bobcat-ft/hardware/microphone_array_adapter_board/readme.md

Adapter board used to interface with a 4x4 [TDK Invensense ICS-52000 eval board](https://www.digikey.com/en/product-highlight/i/invensense/ics-52000-tdm-array-demo-board).

The eval board is a 4x4 array of ICS-52000 bottom-port MEMs microphones.
