bobcat-ft/hardware/audio_beamforming_daughter_board/audio_beamforming_daughter_board.png

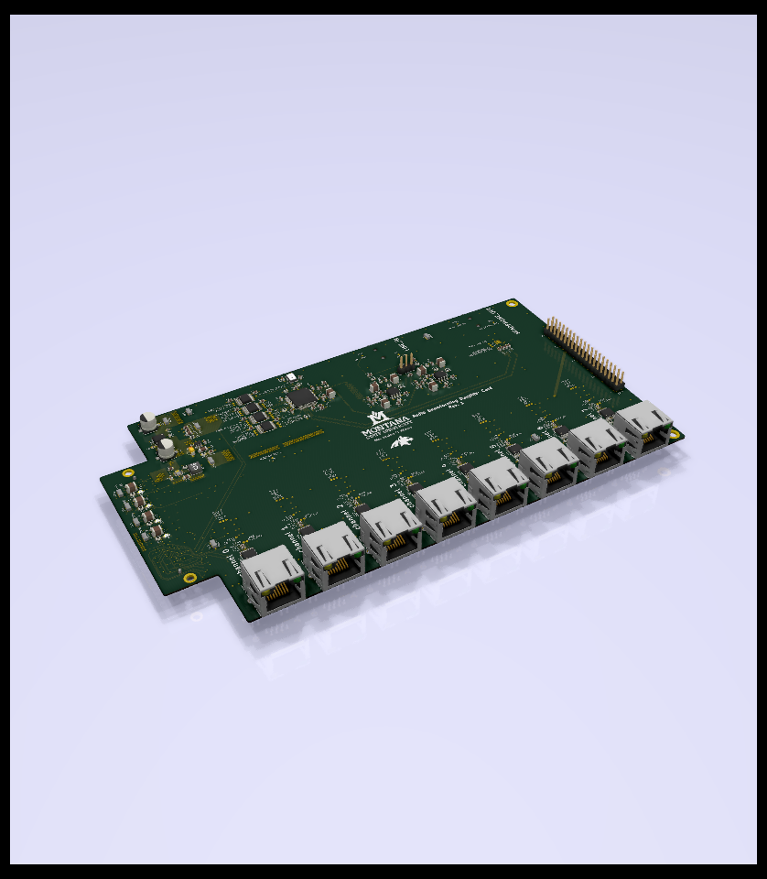
audio_beamforming_daughter_board/audio_beamforming_daughter_board.png
