bobcat-ft/hardware/microphone_array_adapter_board/microphone_array_adapter_board.png

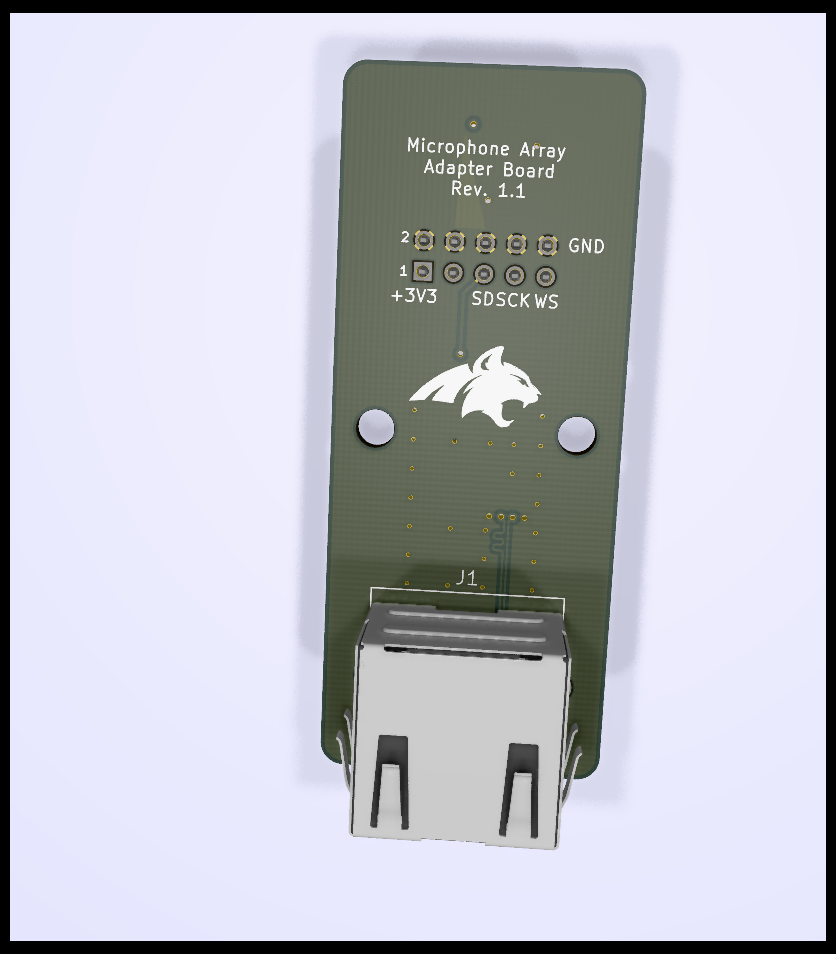
microphone_array_adapter_board/microphone_array_adapter_board.png
