bobcat-ft/hardware/microphone_array_adapter_board/microphone_array_adapter_board.stl

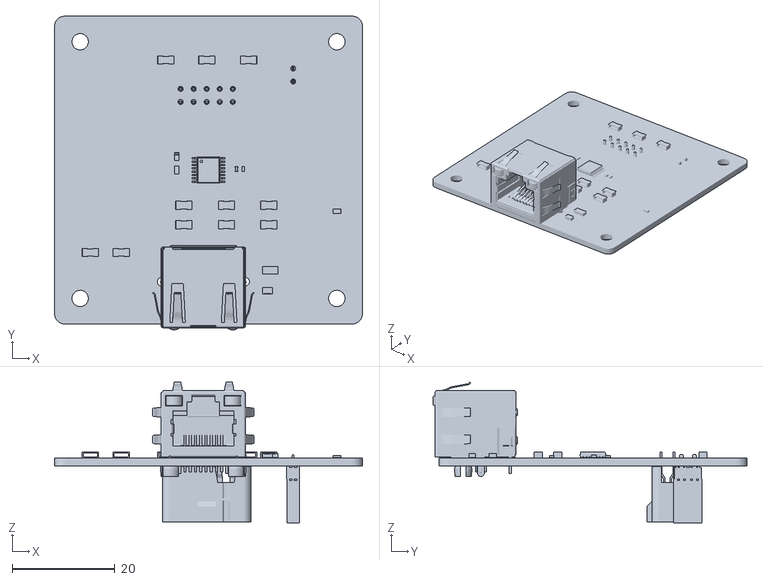
[picture p3: CAD file, 2020-04-23]
microphone_array_adapter_board/microphone_array_adapter_board.stl
60.0 x 61.1 x 27.4
