bobcat-ft/hardware/audio_beamforming_daughter_board/audio_beamforming_daughter_board.pdf

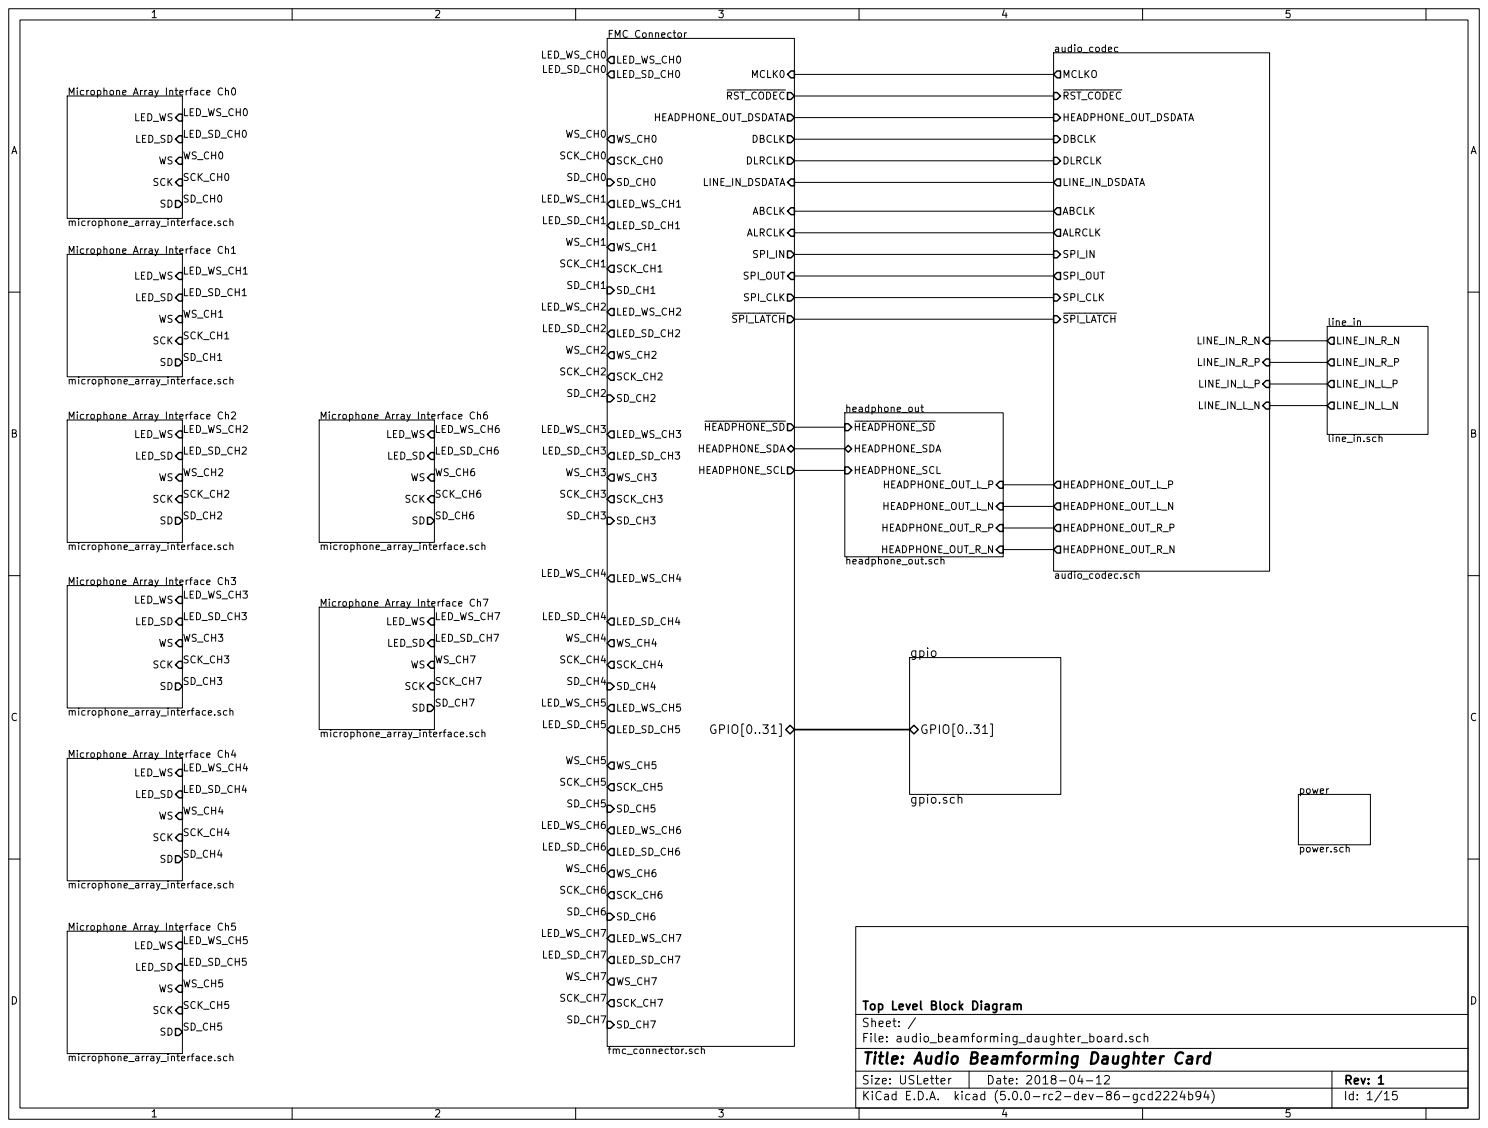
[picture p4: page 1]

File: audio_beamforming_daughter_board.sch Sheet: / Top Level Block Diagram

Id: 1/15 Title: Audio Beamforming Daughter Card

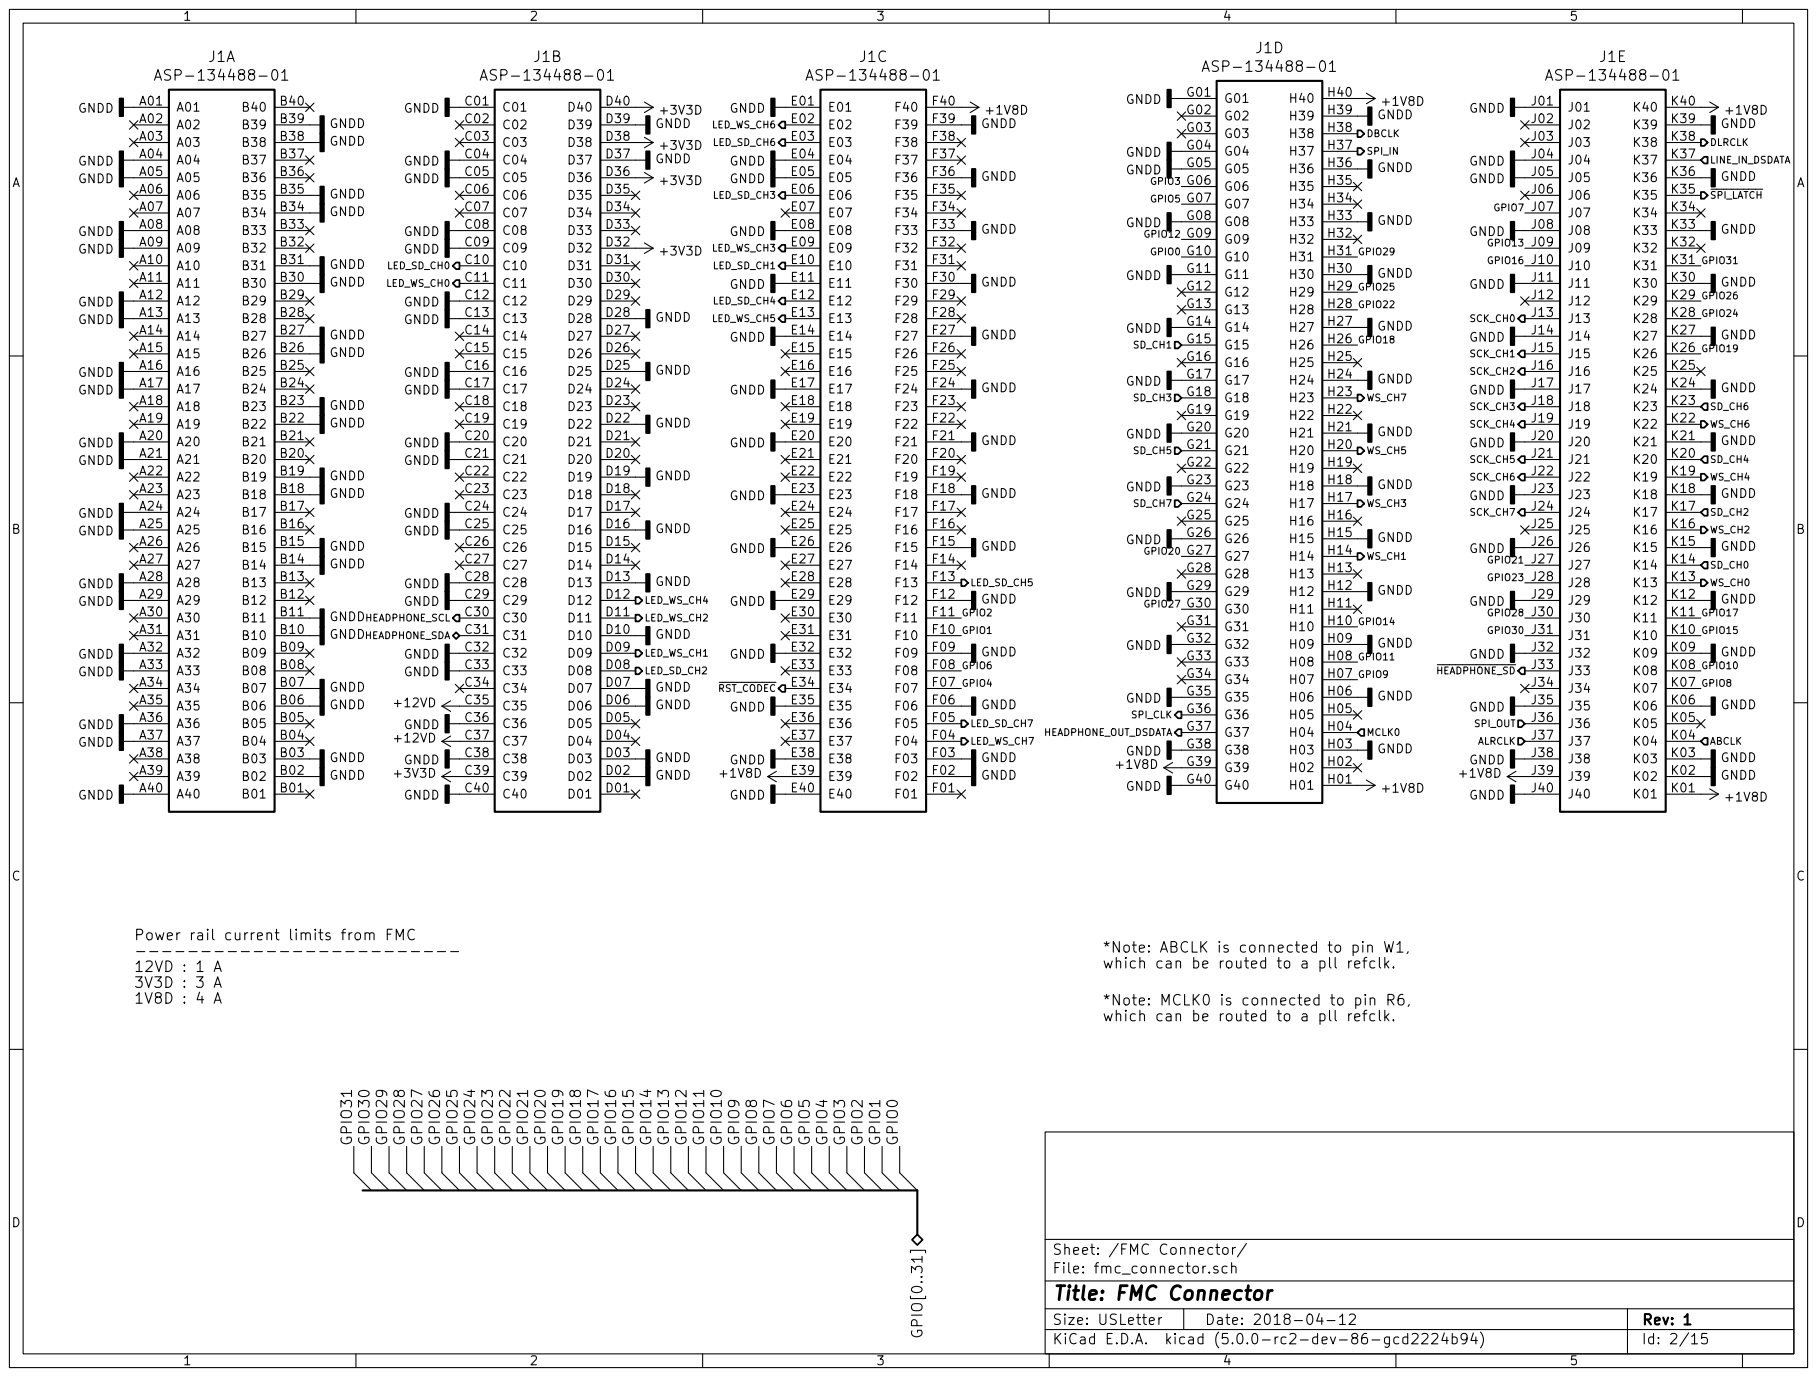
[picture p5: page 2]

*Note: ABCLK is connected to pin W1,
which can be routed to a pll refclk.

*Note: MCLK0 is connected to pin R6,

File: fmc_connector.sch Sheet: /FMC Connector/
Id: 2/15 Title: FMC Connector

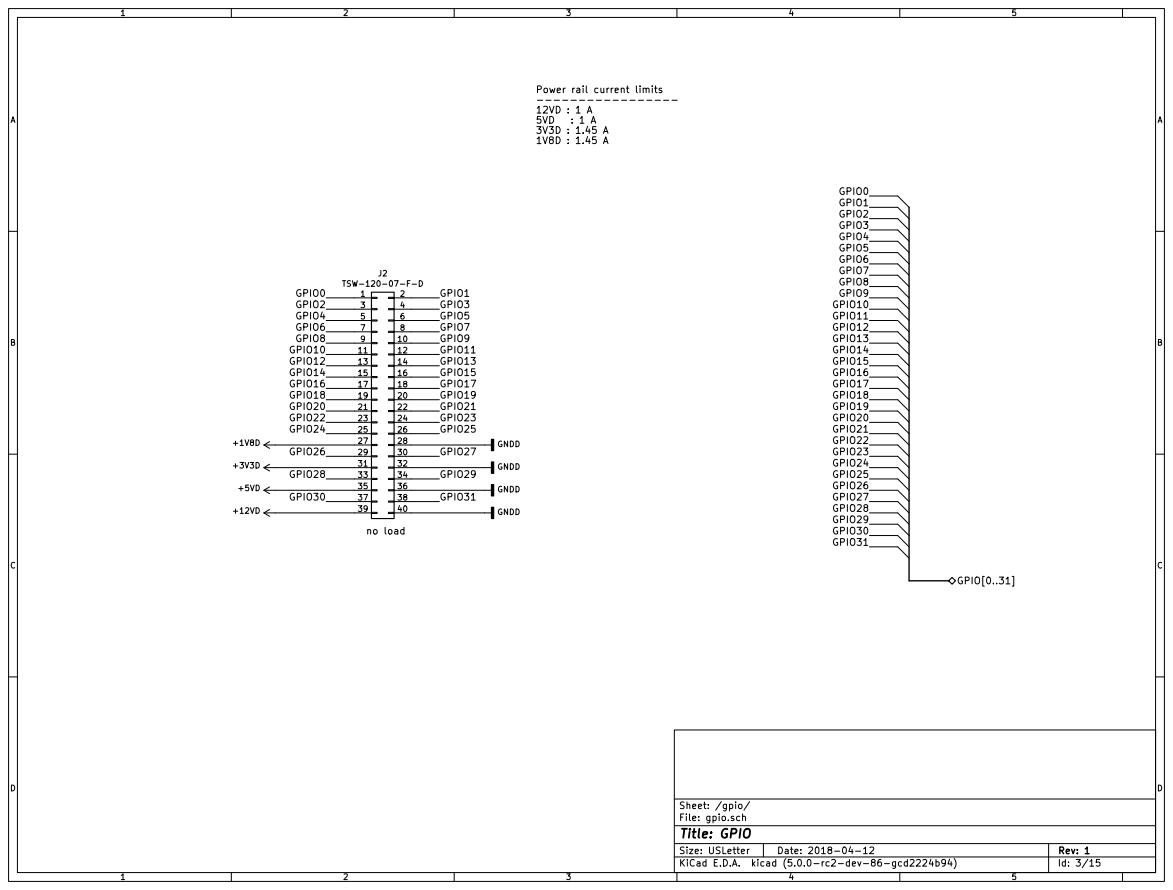
[picture p6: page 3]

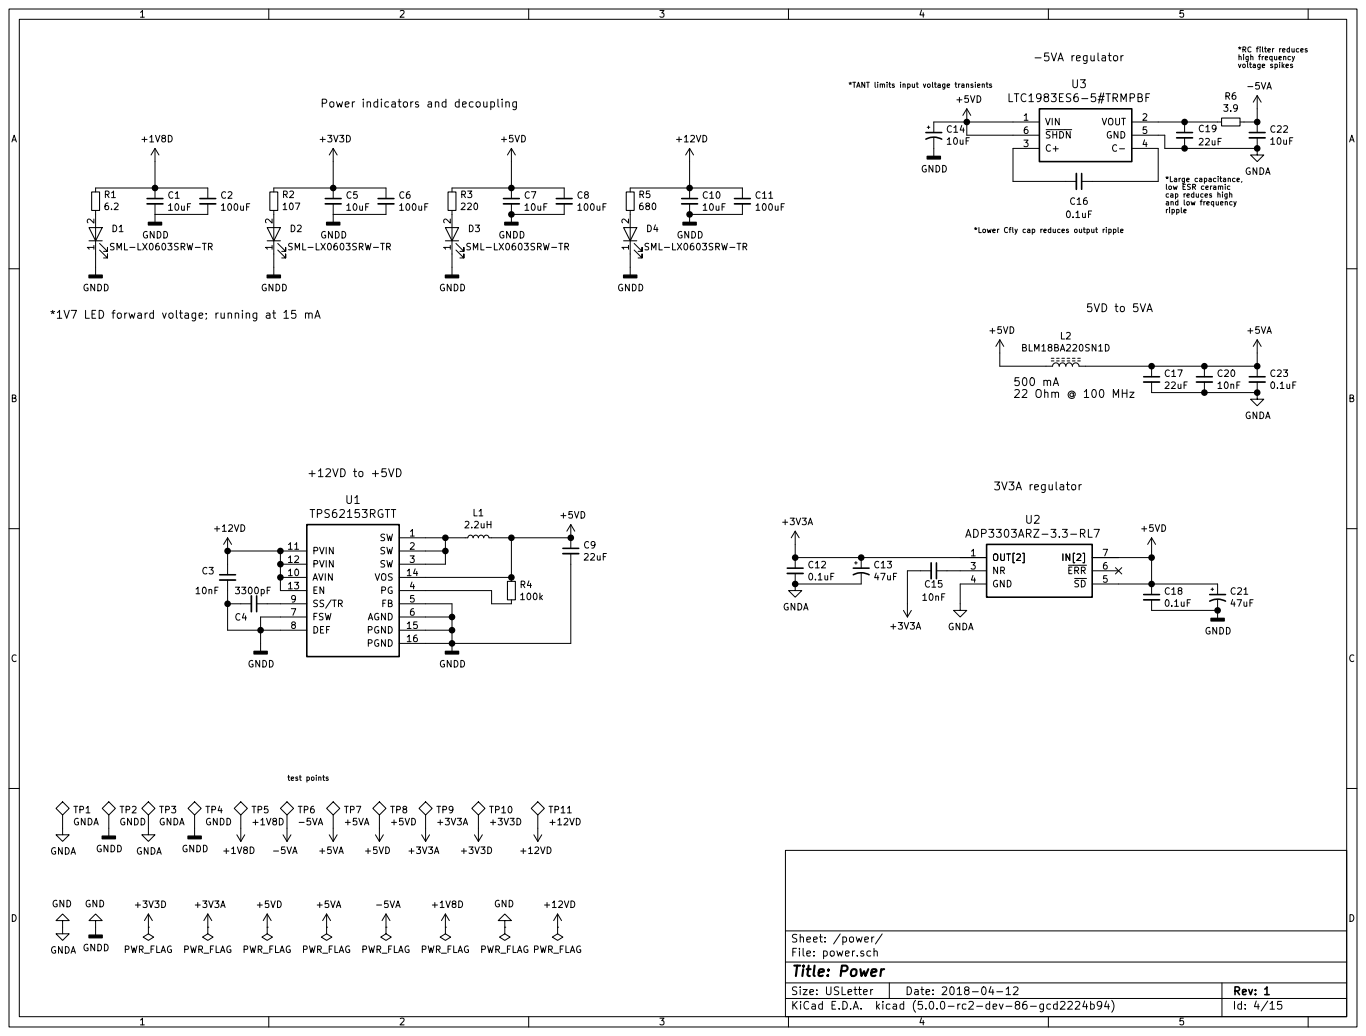
[picture p7: page 4]

*RC filter reduces high frequency voltage spikes

-5VA Power indicators and decoupling

*TANT limits input voltage transients

*Large capacitance,
low ESR ceramic cap reduces high
and low frequency
ripple

*Lower Cfly cap reduces output ripple

*1V7 LED forward voltage; running at 15 mA

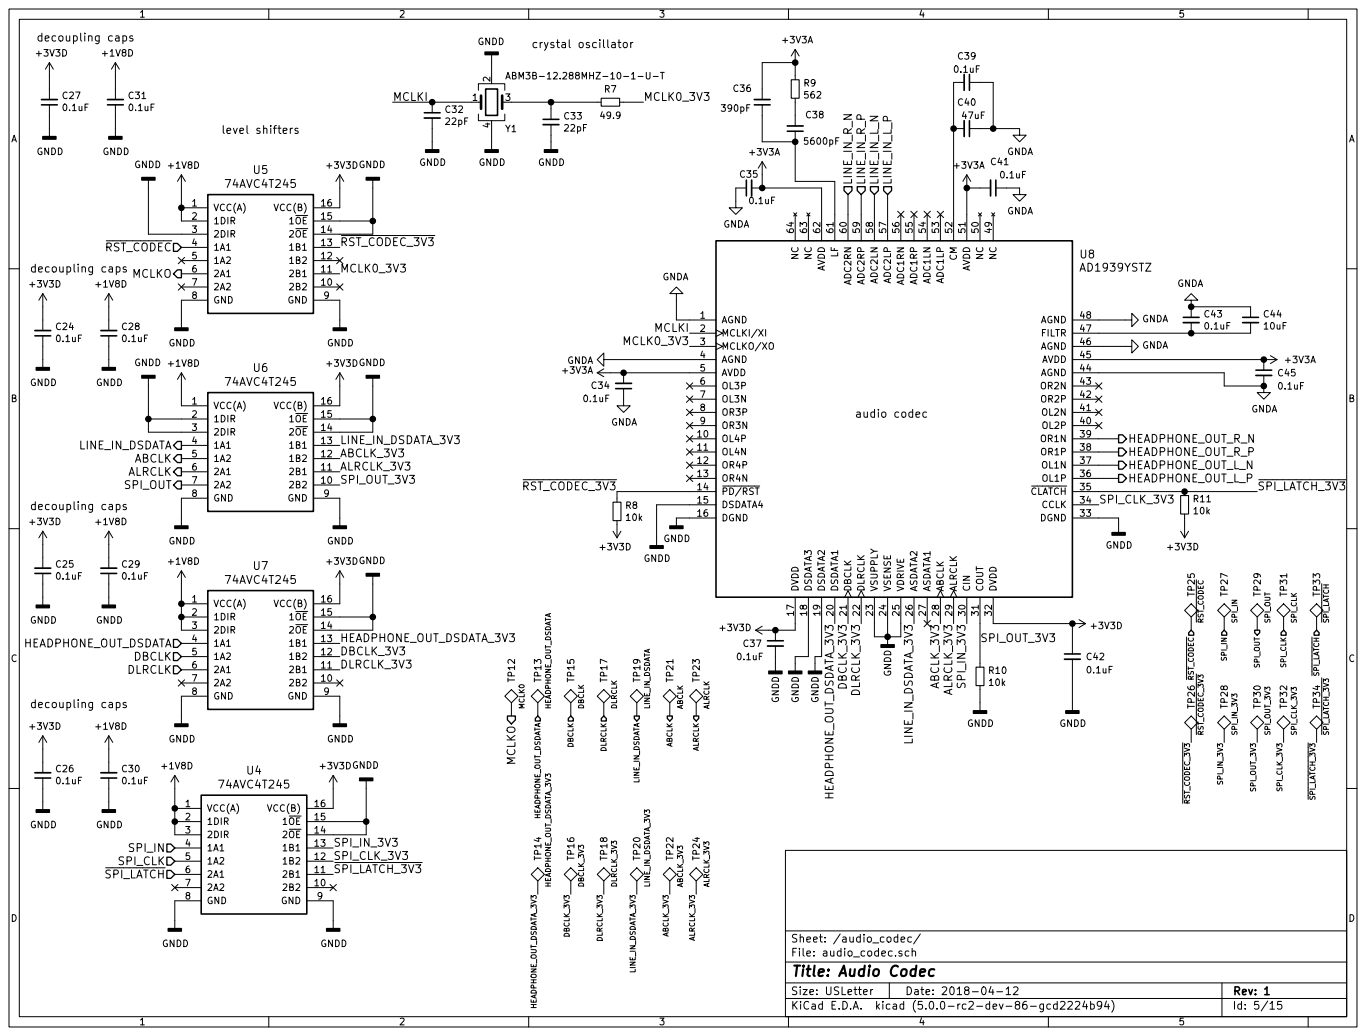
[picture p8: page 5]

4Y1 ABM3B-12.288MHZ-10-1-U-T AGND 1 MCLKI/XI 2 MCLKO/XO 3 AGND 4 AVDD 5 OL3P 6 OL3N 7 OR3P 8 OR3N 9 OL4P 10 OL4N 11 OR4P 12 OR4N 13 PD/RST 14 DSDATA4 15 DGND 16 DVDD 17 DSDATA3 18 DSDATA2 19 DSDATA1 20 DBCLK 21 DLRCLK 22 VSUPPLY 23 VSENSE 24 VDRIVE 25 ASDATA2 26 ASDATA1 27 ABCLK 28 ALRCLK 29 CIN 30 COUT 31 DVDD 32 DGND 33 CCLK 34 CLATCH 35 OL1P 36 OL1N 37 OR1P 38 OR1N 39 OL2P 40 OL2N 41 OR2P 42 OR2N 43 AGND 44 AVDD 45 AGND 46 FILTR 47 AGND 48 NC 49 NC 50 AVDD 51 CM 52 ADC1LP 53 ADC1LN 54 ADC1RP 55 ADC1RN 56 ADC2LP 57 ADC2LN 58 ADC2RP 59 ADC2RN 60 LF 61 AVDD 62 NC 63 NC 64 U8AD1939YSTZ GNDD GNDD

Sheet: /audio_codec/
File: audio_codec.sch
Id: 5/15 Title: Audio Codec

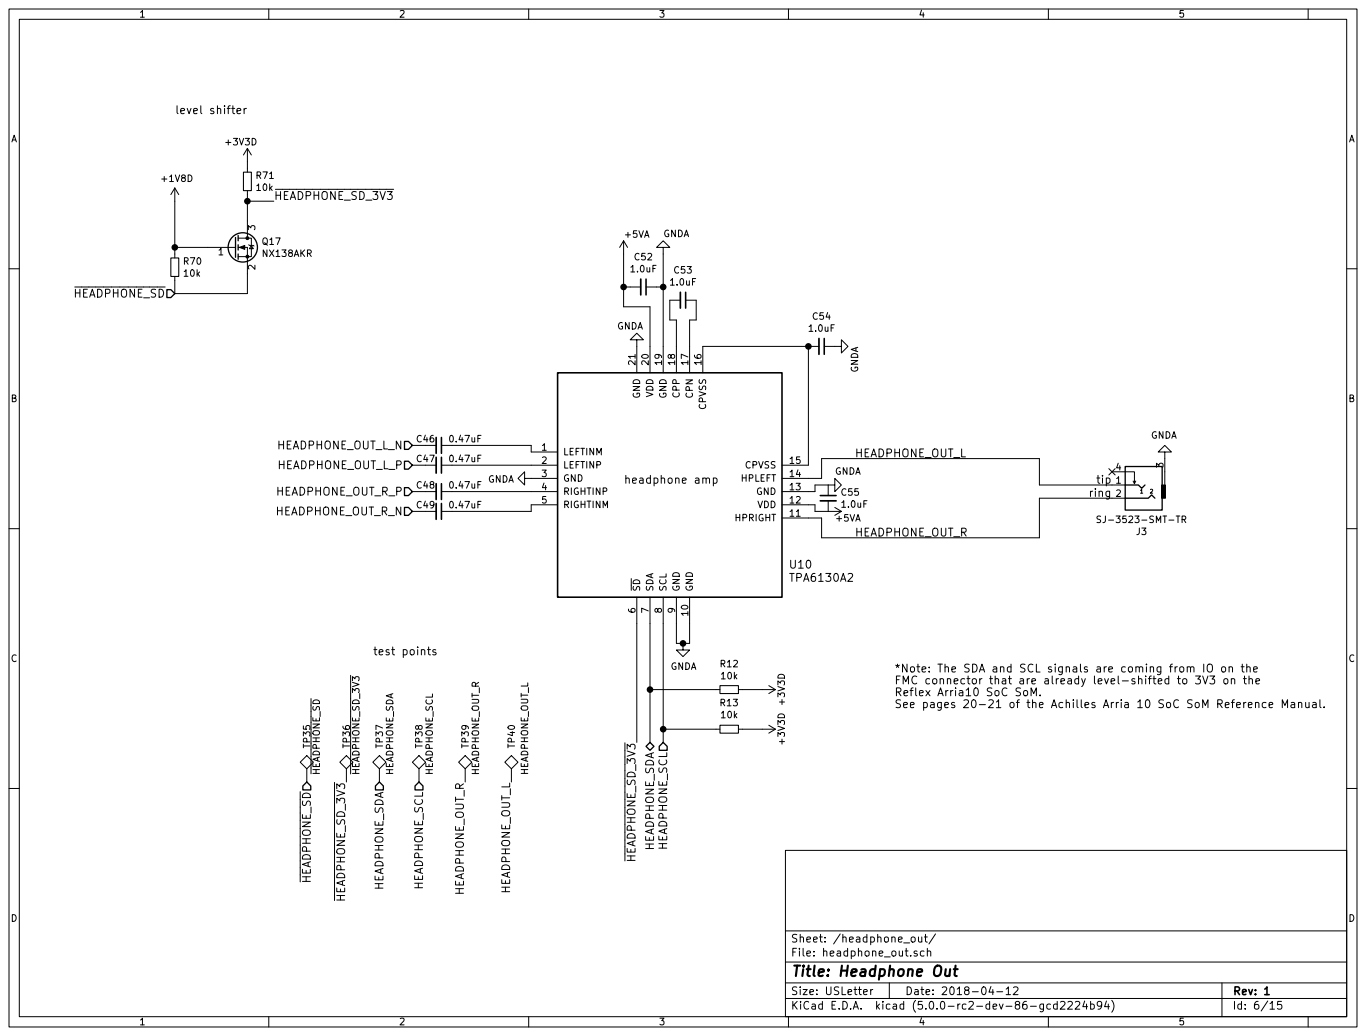
[picture p9: page 6]

9 GND 10 HPRIGHT 11 VDD 12 GND 13 HPLEFT 14 CPVSS 15 CPVSS 16 CPN 17 CPP 18 GND 19 VDD 20 GND 21 U10 TPA6130A2

J3 SJ-3523-SMT-TR GNDA

*Note: The SDA and SCL signals are coming from IO on the
FMC connector that are already level-shifted to 3V3 on the
Reflex Arria10 SoC SoM.
See pages 20-21 of the Achilles Arria 10 SoC SoM Reference Manual.

Sheet: /headphone_out/
File: headphone_out.sch
Id: 6/15 Title: Headphone Out

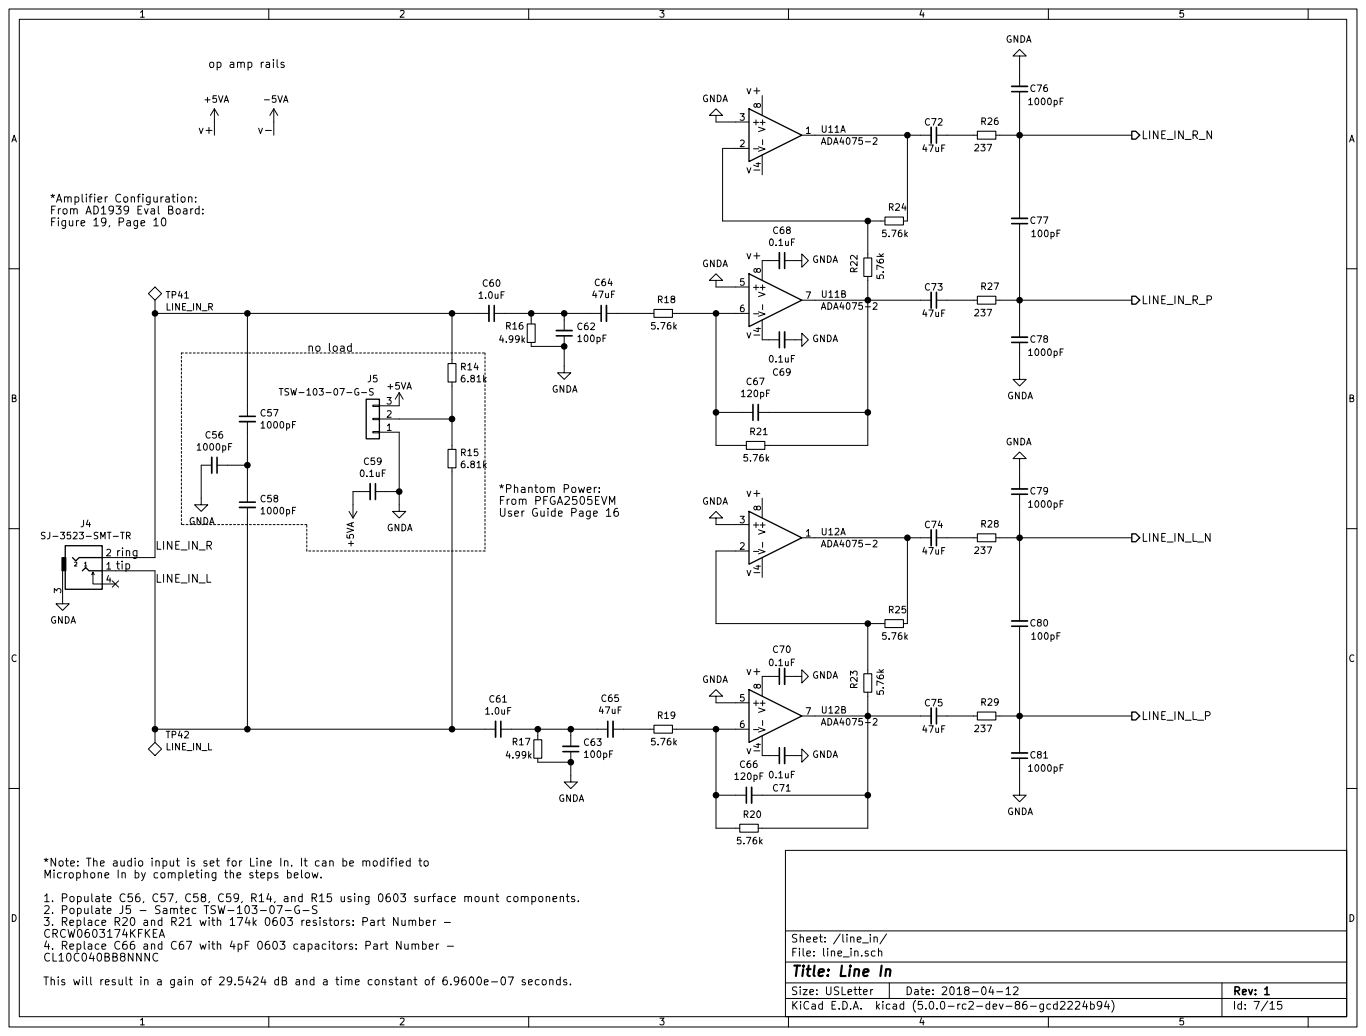
[picture p10: page 7]

*Amplifier Configuration: From AD1939 Eval Board: Figure 19, Page 10

*Note: The audio input is set for Line In. It can be modified to
Microphone In by completing the steps below.
1. Populate C56, C57, C58, C59, R14, and R15 using 0603 surface mount components.
2. Populate J5 - Samtec TSW-103-07-G-S
3. Replace R20 and R21 with 174k 0603 resistors: Part Number -
CRCW0603174KFKEA
4. Replace C66 and C67 with 4pF 0603 capacitors: Part Number -
CL10C040BB8NNNC
This will result in a gain of 29.5424 dB and a time constant of 6.9600e-07 seconds.

Sheet: /line_in/
File: line_in.sch
Id: 7/15 Title: Line In

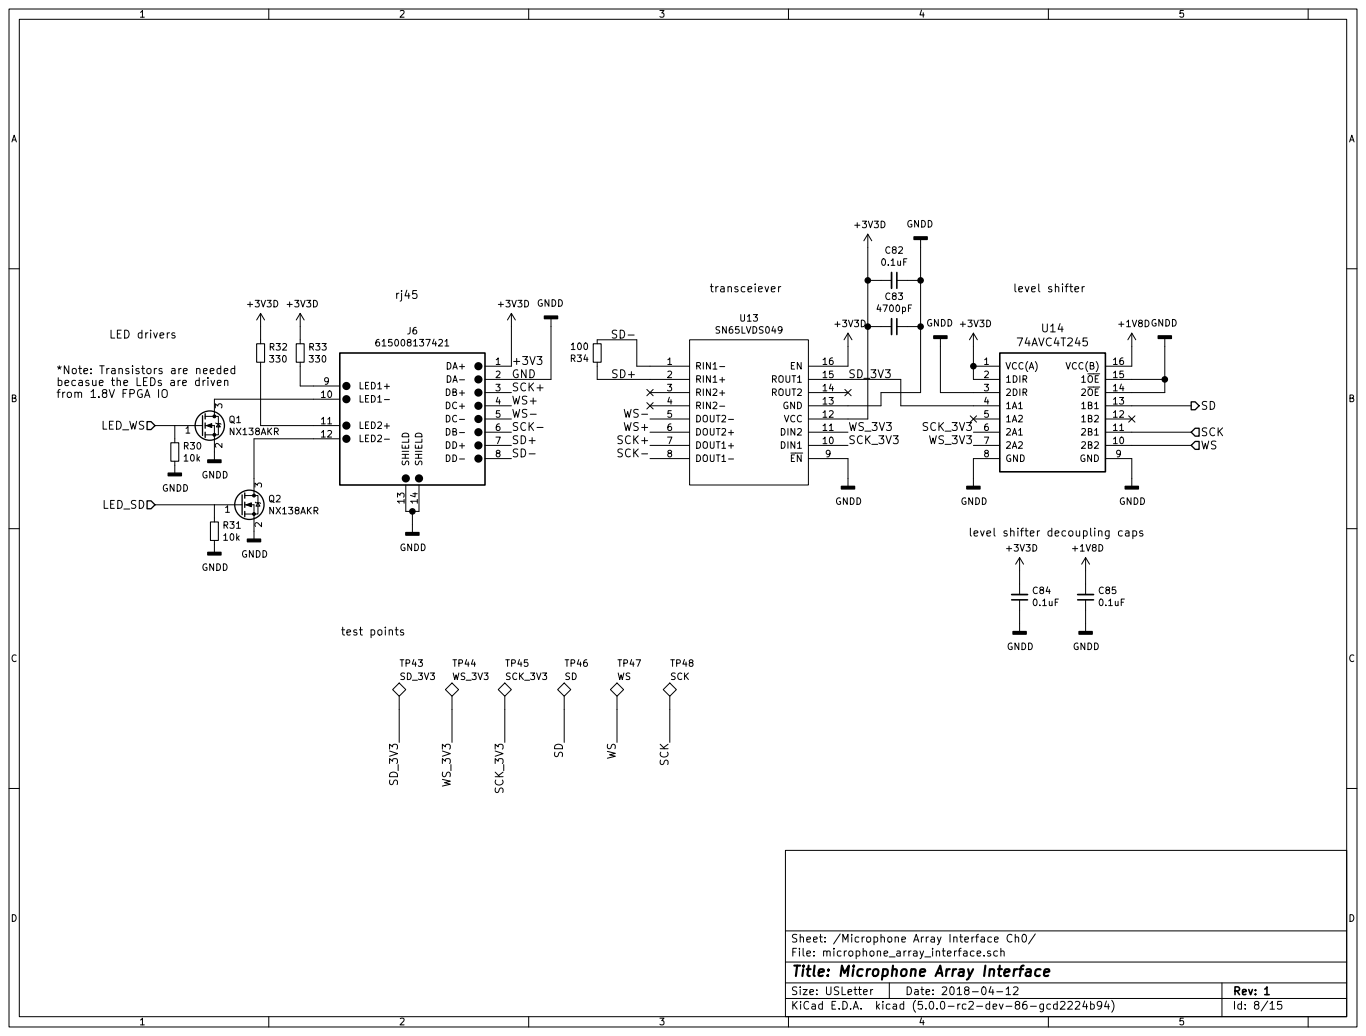
[picture p11: page 8]

*Note: Transistors are needed becasue the LEDs are driven
from 1.8V FPGA IO

level shifter decoupling caps

Sheet: /Microphone Array Interface Ch0/
File: microphone_array_interface.sch
Id: 8/15 Title: Microphone Array Interface

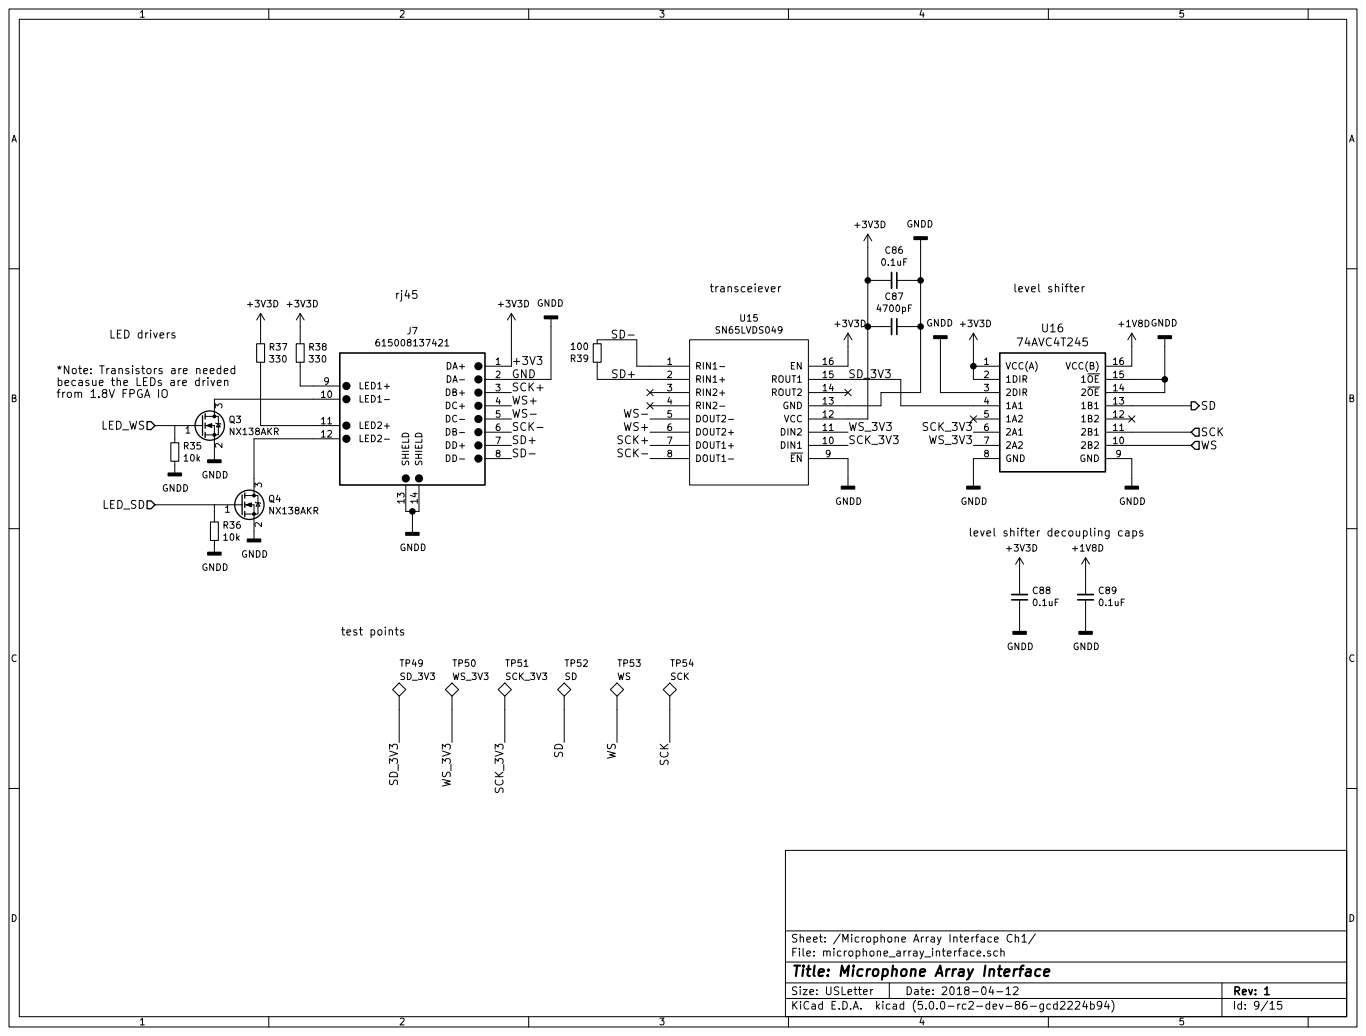
[picture p12: page 9]

*Note: Transistors are needed becasue the LEDs are driven
from 1.8V FPGA IO

level shifter decoupling caps

Sheet: /Microphone Array Interface Ch1/
File: microphone_array_interface.sch
Id: 9/15 Title: Microphone Array Interface

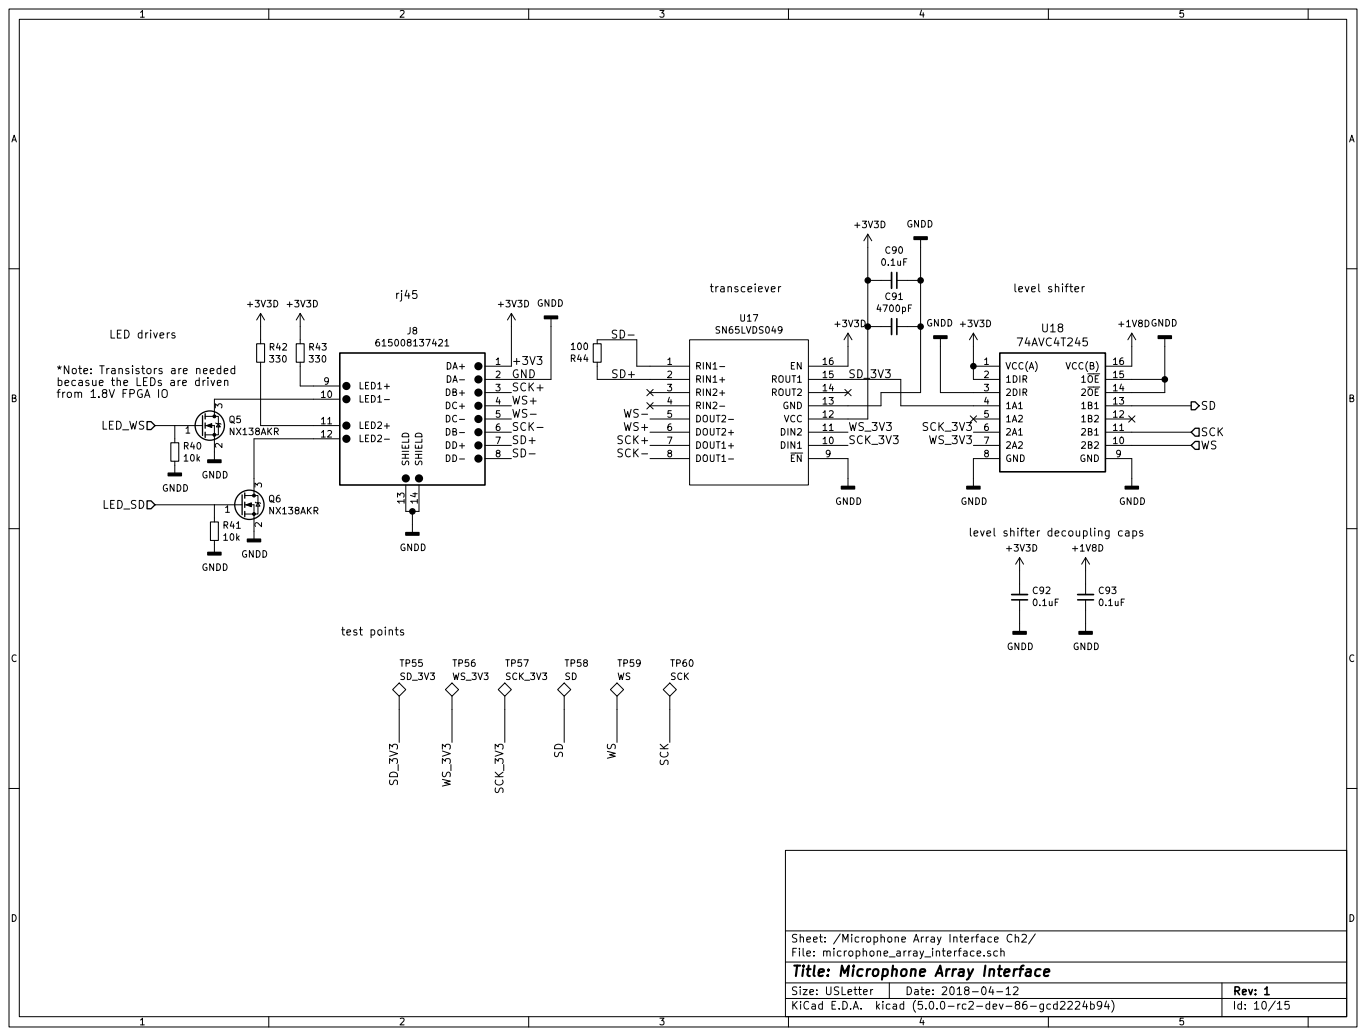
[picture p13: page 10]

*Note: Transistors are needed becasue the LEDs are driven
from 1.8V FPGA IO

level shifter decoupling caps

Sheet: /Microphone Array Interface Ch2/
File: microphone_array_interface.sch
Id: 10/15 Title: Microphone Array Interface

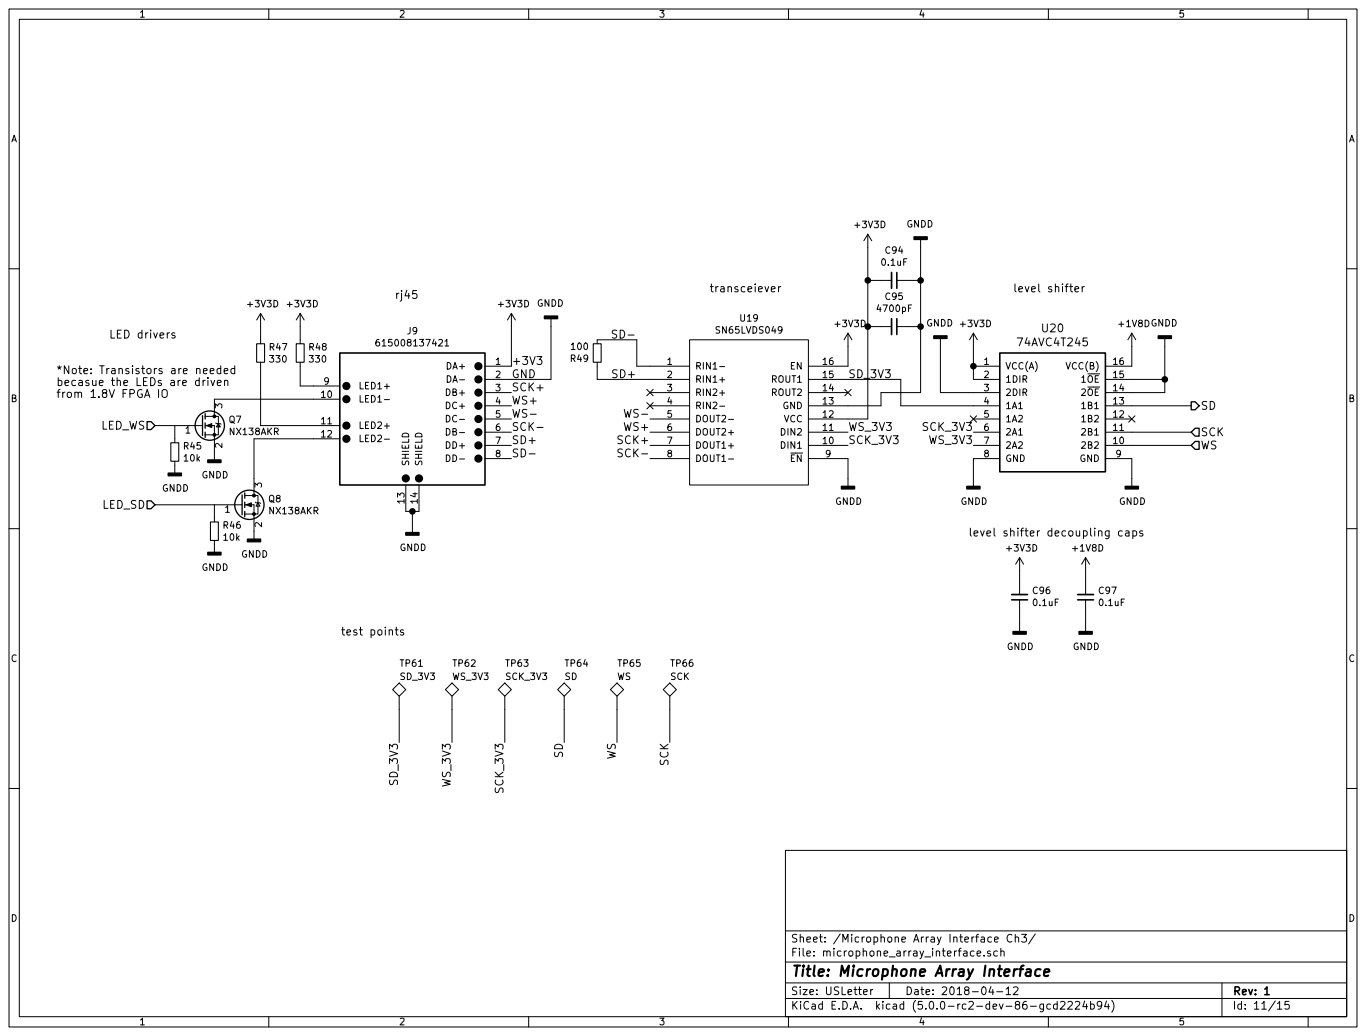
[picture p14: page 11]

*Note: Transistors are needed becasue the LEDs are driven
from 1.8V FPGA IO

level shifter decoupling caps

Sheet: /Microphone Array Interface Ch3/
File: microphone_array_interface.sch
Id: 11/15 Title: Microphone Array Interface

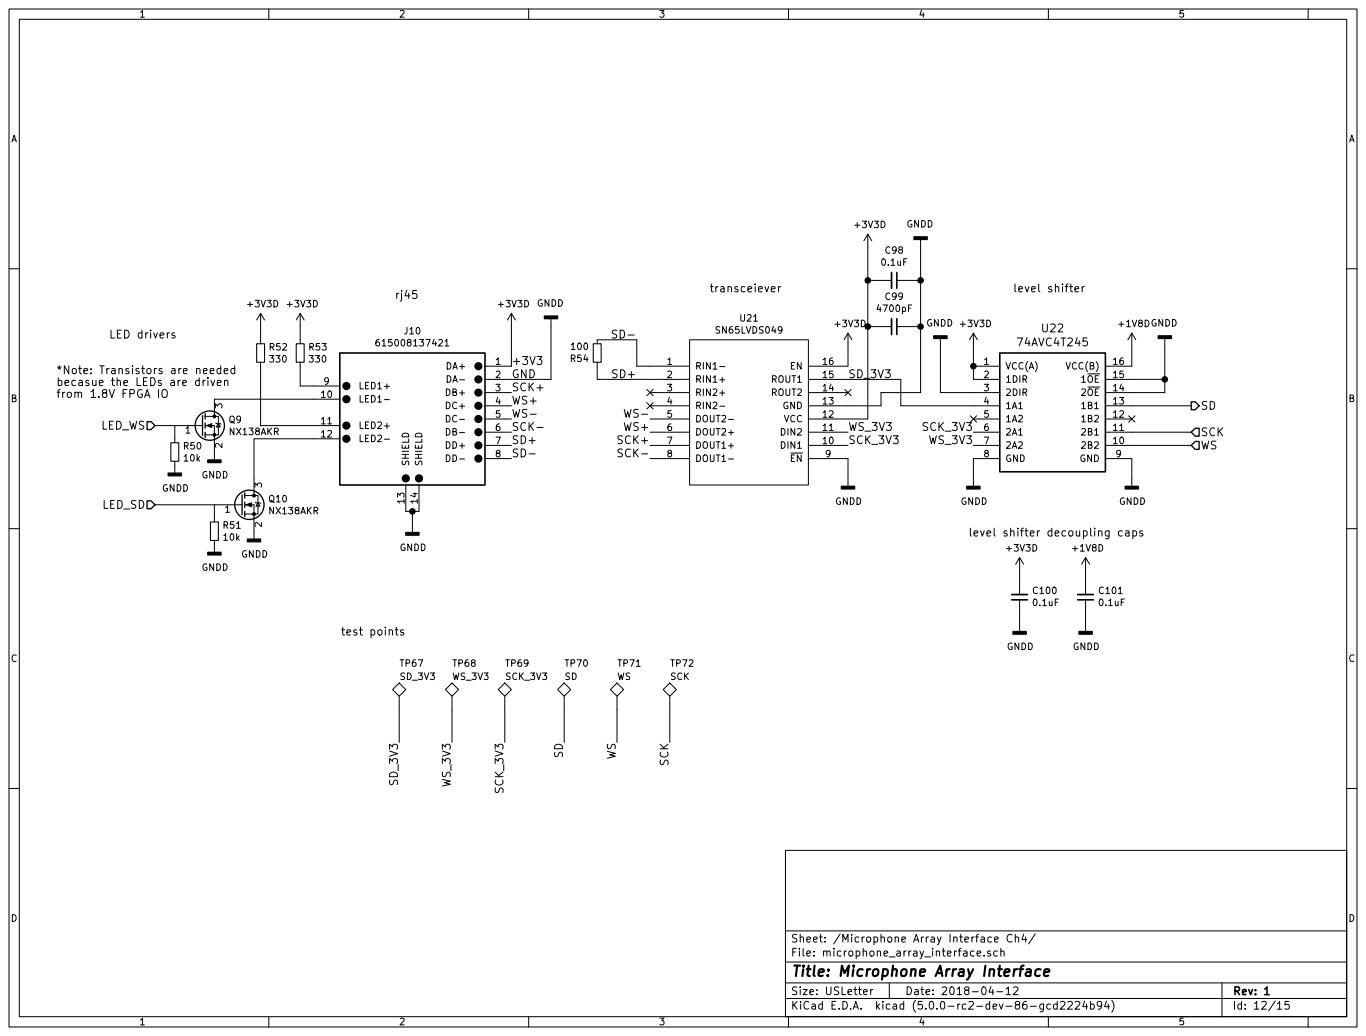
[picture p15: page 12]

*Note: Transistors are needed becasue the LEDs are driven
from 1.8V FPGA IO

level shifter decoupling caps

Sheet: /Microphone Array Interface Ch4/
File: microphone_array_interface.sch
Id: 12/15 Title: Microphone Array Interface

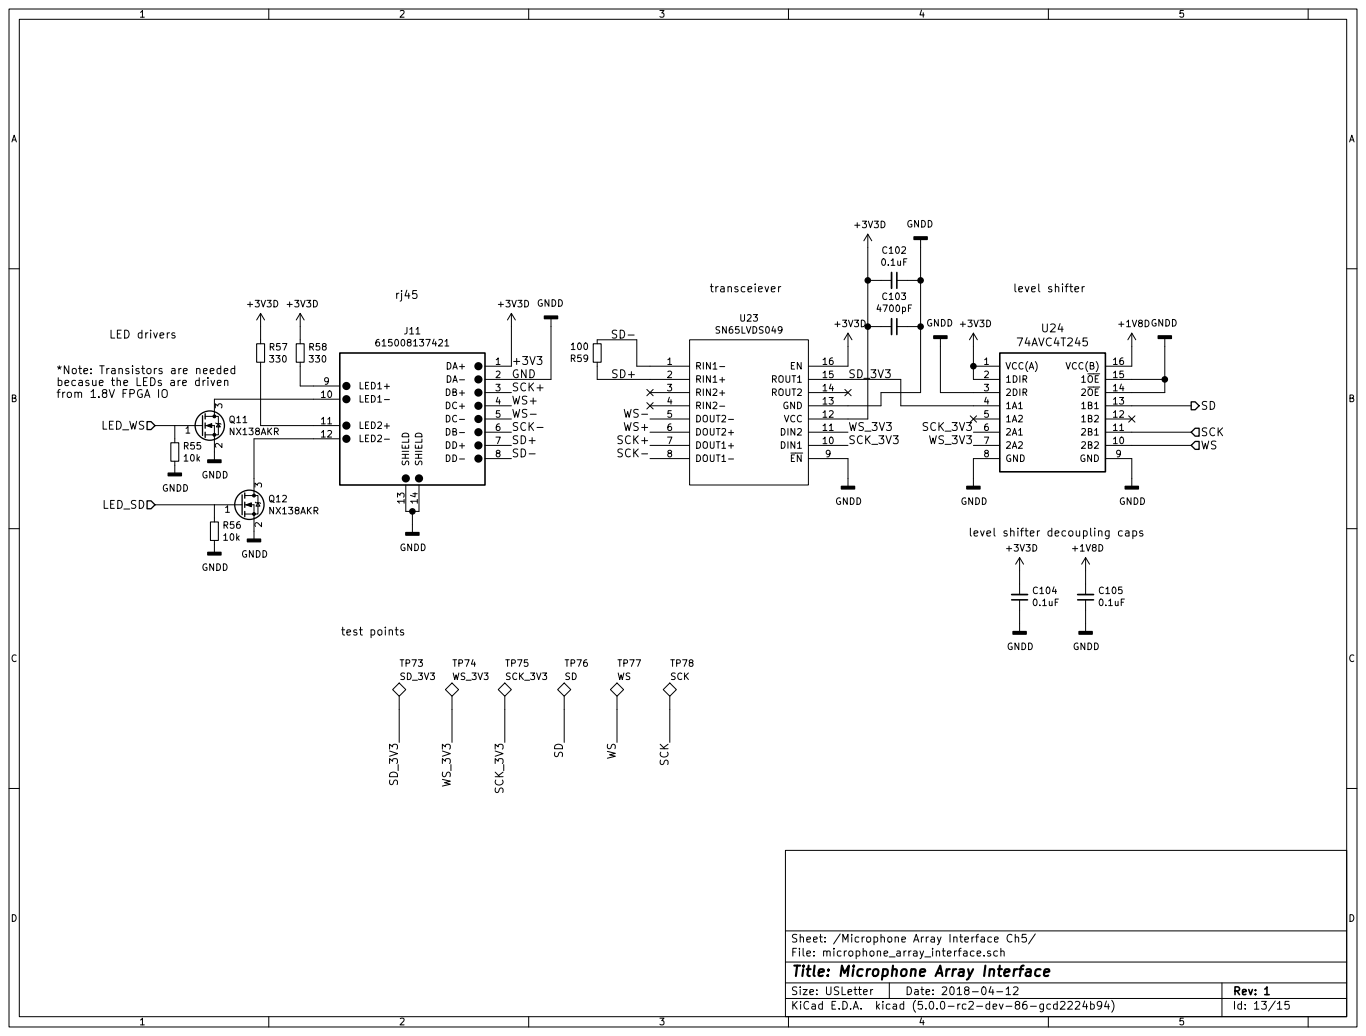
[picture p16: page 13]

*Note: Transistors are needed becasue the LEDs are driven
from 1.8V FPGA IO

level shifter decoupling caps

Sheet: /Microphone Array Interface Ch5/
File: microphone_array_interface.sch
Id: 13/15 Title: Microphone Array Interface

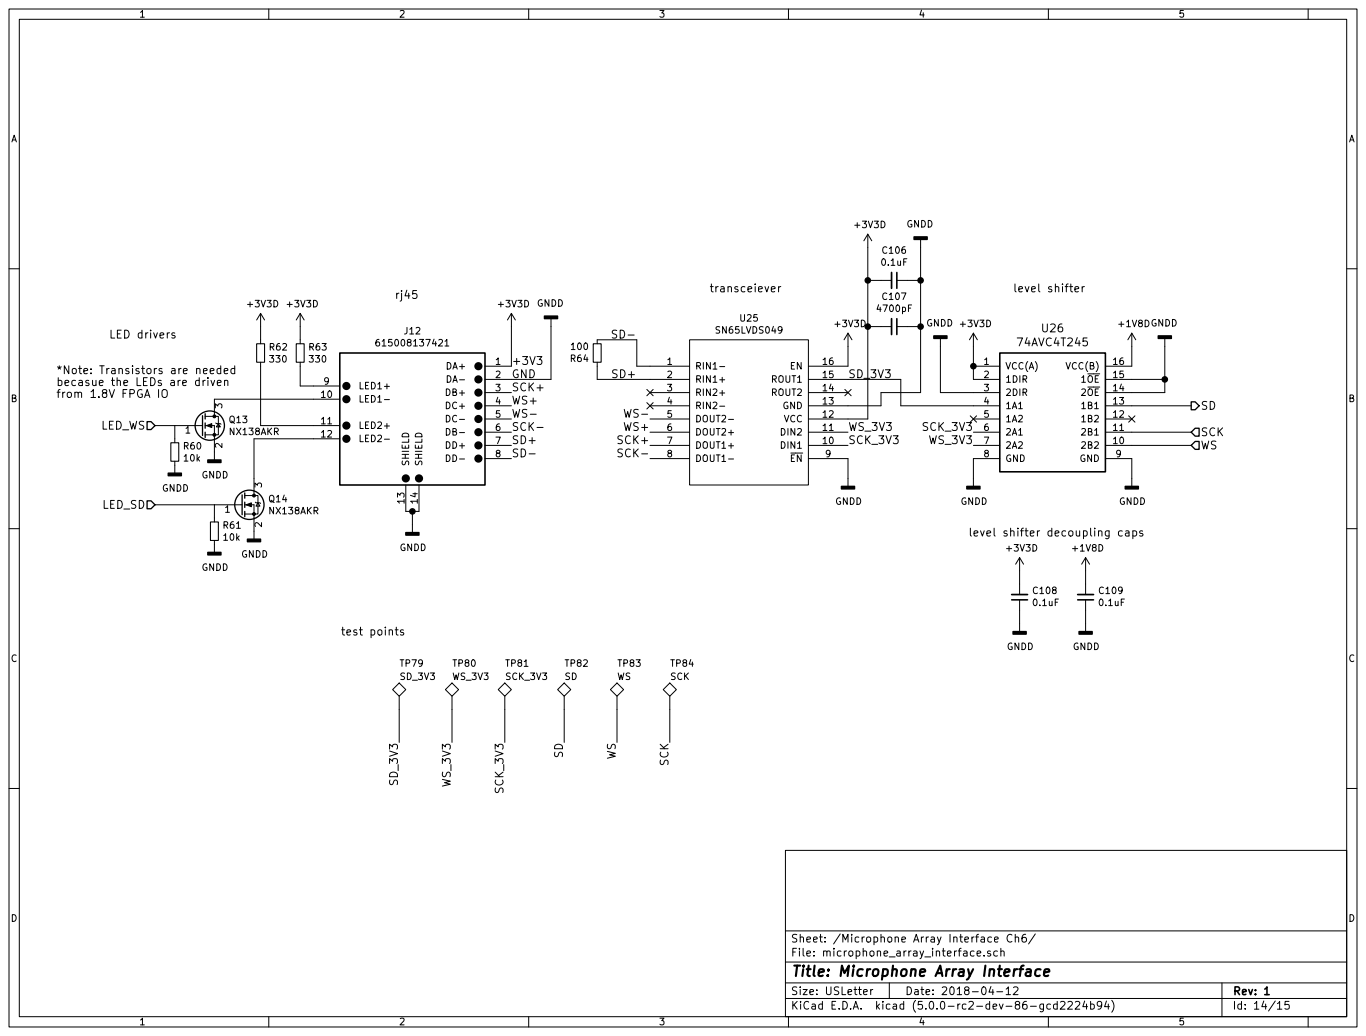
[picture p17: page 14]

*Note: Transistors are needed becasue the LEDs are driven
from 1.8V FPGA IO

level shifter decoupling caps

Sheet: /Microphone Array Interface Ch6/
File: microphone_array_interface.sch
Id: 14/15 Title: Microphone Array Interface

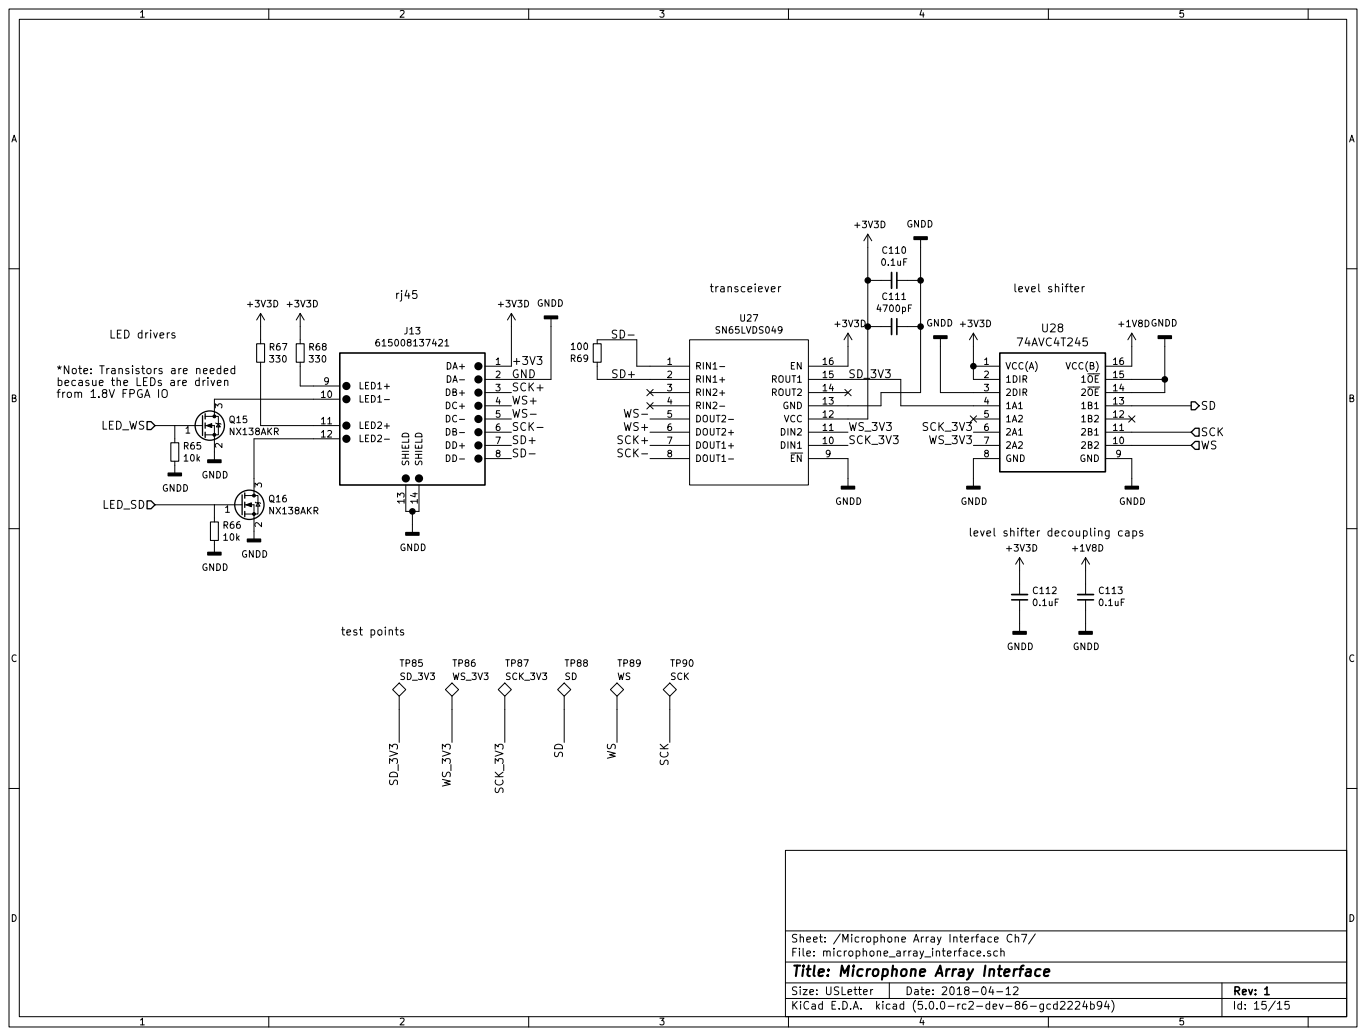
[picture p18: page 15]

*Note: Transistors are needed becasue the LEDs are driven
from 1.8V FPGA IO

level shifter decoupling caps

Sheet: /Microphone Array Interface Ch7/
File: microphone_array_interface.sch
Id: 15/15 Title: Microphone Array Interface
