bobcat-ft/hardware/microphone_array_adapter_board/microphone_array_adapter_board.kicad_pcb

## KiCad design microphone_array_adapter_board/microphone_array_adapter_board.kicad_pcb (2020-04-23)

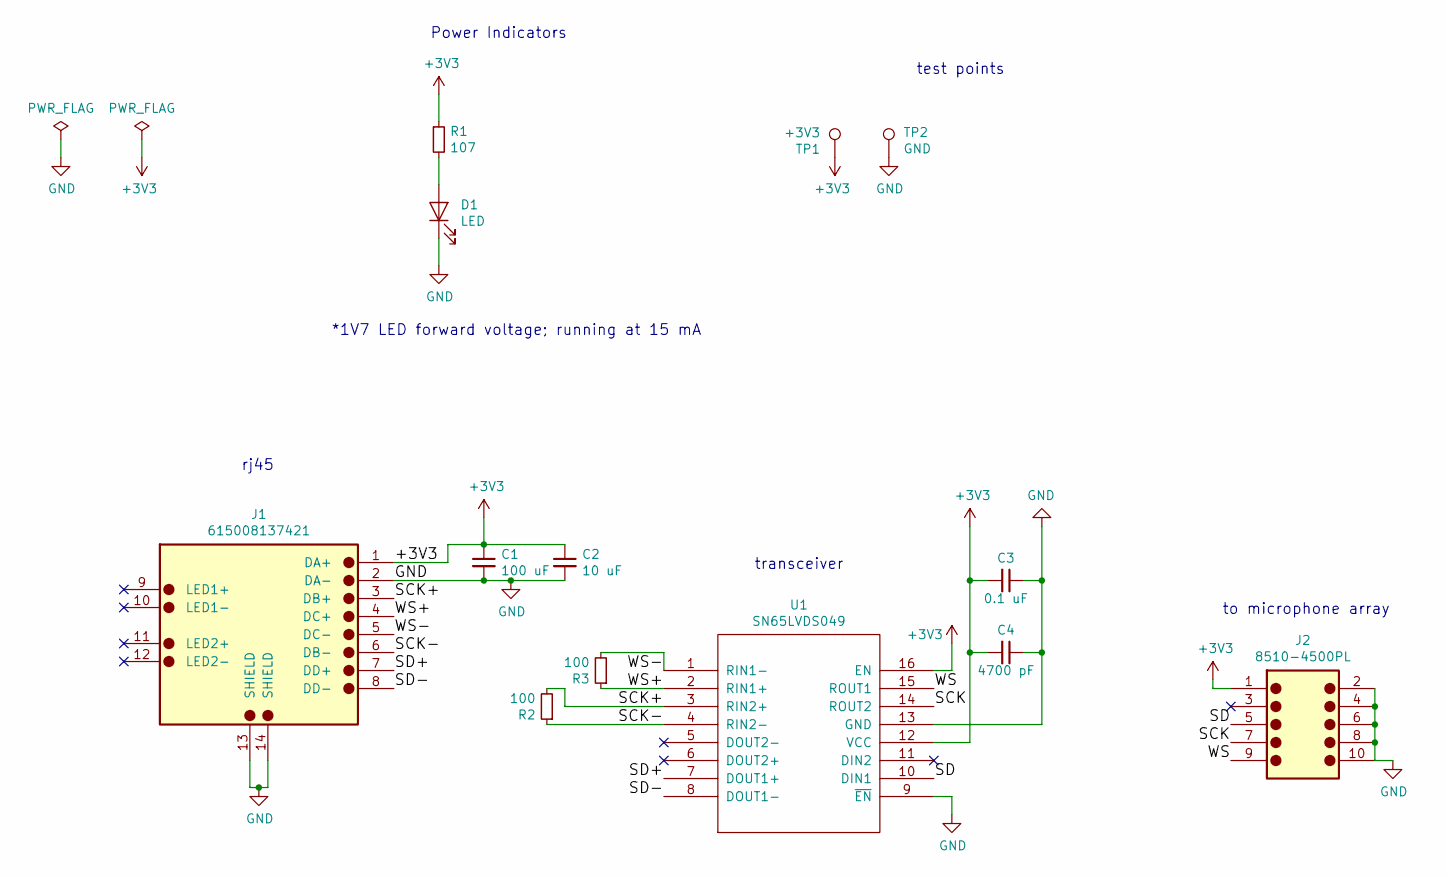
[picture p19: schematic microphone_array_adapter_board.sch, Microphone Array Adapater Board]

Parts:
C1: 100 uF; C_1210_3225Metric; Manufacturer Part Number CL32X107MQVNNNE
C2: 10 uF; C_0603_1608Metric; Manufacturer Part Number C1608X5R1A106K080AC
C3: 0.1 uF; C_0402_1005Metric; Manufacturer Part Number CGA2B1X7R1C104M050BC
C4: 4700 pF; C_0402_1005Metric; Manufacturer Part Number CGA2B2X7R1H472M050BA
D1: LED; LED_0603_1608Metric; Manufacturer Part Number SML-LX0603SRW-TR
J1: 615008137421; WURTH_615008137421; Manufacturer Part Number 615008137421
J2: 8510-4500PL; 3M_8510-4500PL; Manufacturer Part Number 8510-4500PL
R1: 107; R_0603_1608Metric; Manufacturer Part Number ERJ-3EKF1070V
R2, R3: 100; R_0603_1608Metric; Manufacturer Part Number ERA-3AEB101V
TP1: +3V3; Measurement_Point_SMD_1206; Manufacturer Part Number RCS-0C
TP2: GND; Measurement_Point_SMD_1206; Manufacturer Part Number RCS-0C
U1: SN65LVDS049; TSSOP-16_4.4x5mm_P0.65mm; Manufacturer Part Number SN65LVDS049PWR

Connections:
+3V3: C1.1, C2.1, C3.2, C4.2, J1.1 (DA+), J2.1, R1.1, TP1.1, U1.12 (VCC), U1.16 (EN)
/SCK: J2.7, U1.14 (ROUT2)
/SCK+: J1.3 (DB+), R2.2, U1.3 (RIN2+)
/SCK-: J1.6 (DB-), R2.1, U1.4 (RIN2-)
/SD: J2.5, U1.10 (DIN1)
/SD+: J1.7 (DD+), U1.7 (DOUT1+)
/SD-: J1.8 (DD-), U1.8 (DOUT1-)
/WS: J2.9, U1.15 (ROUT1)
/WS+: J1.4 (DC+), R3.1, U1.2 (RIN1+)
/WS-: J1.5 (DC-), R3.2, U1.1 (RIN1-)
GND: C1.2, C2.2, C3.1, C4.1, D1.1 (K), J1.2 (DA-), J1.13 (SHIELD), J1.14 (SHIELD), J2.2, J2.4, J2.6, J2.8, J2.10, TP2.1, U1.9 (~EN), U1.13 (GND)
unnamed: D1.2 (A), R1.2

Notes on the sheet:
test points
Power Indicators
rj45
transceiver
to microphone array
*1V7 LED forward voltage; running at 15 mA

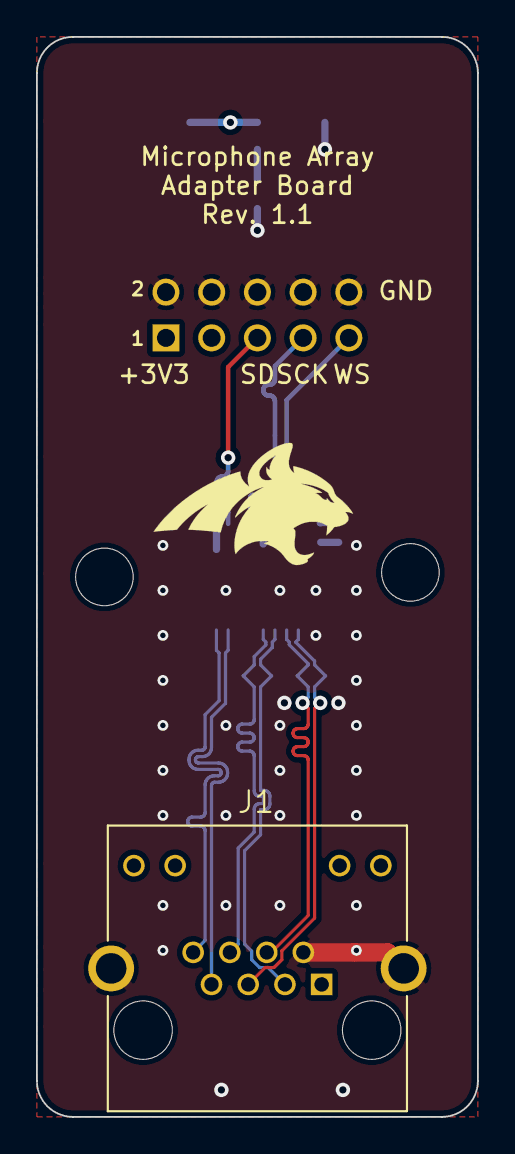
[picture p20: board microphone_array_adapter_board.kicad_pcb from above]

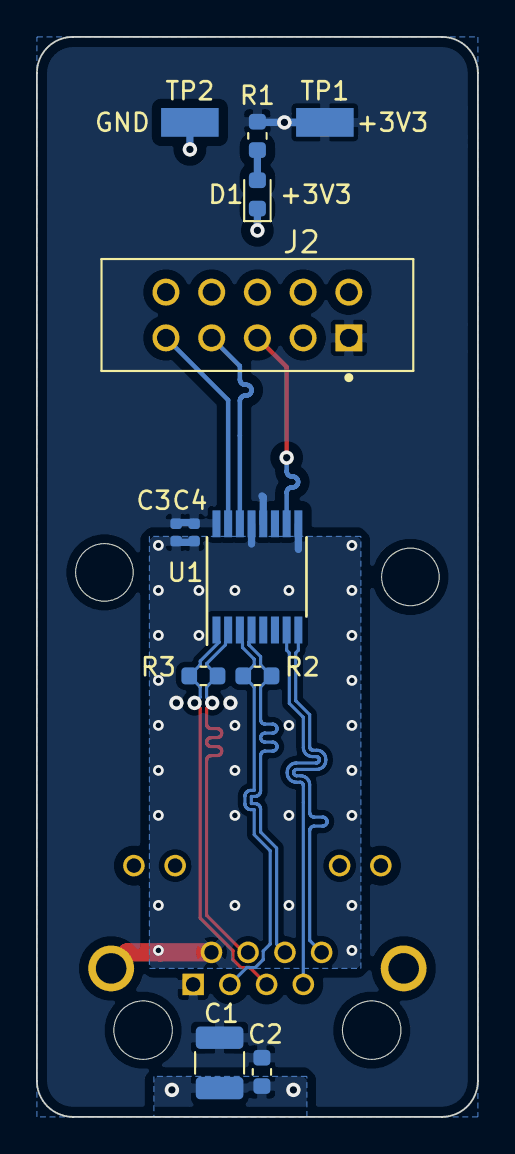
[picture p21: board microphone_array_adapter_board.kicad_pcb from below]

Board: 2 copper layers, 24.5 x 60.0 mm, 13 parts (12 on the bottom side), 12 nets.
