bobcat-ft/hardware/audio_beamforming_daughter_board/audio_beamforming_daughter_board.kicad_pcb

## KiCad design audio_beamforming_daughter_board/audio_beamforming_daughter_board.kicad_pcb (2020-04-23)

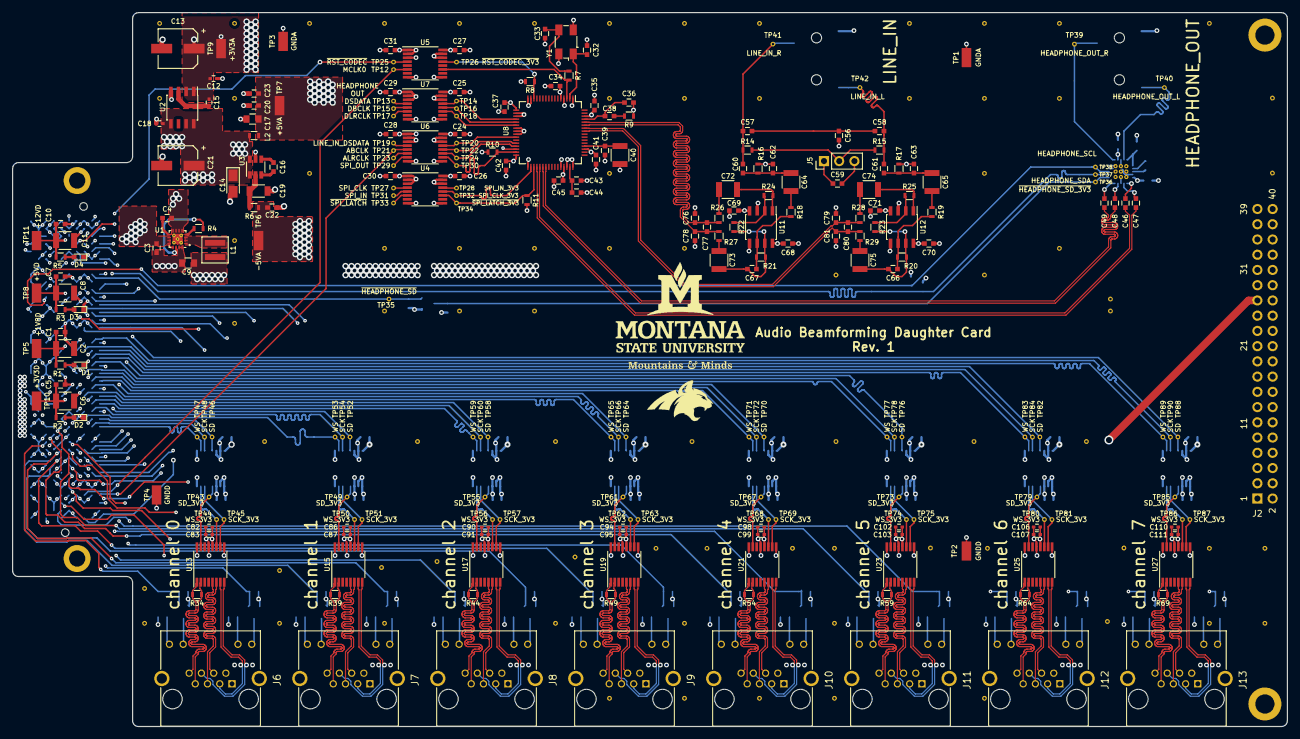
[picture p22: board audio_beamforming_daughter_board.kicad_pcb from above]

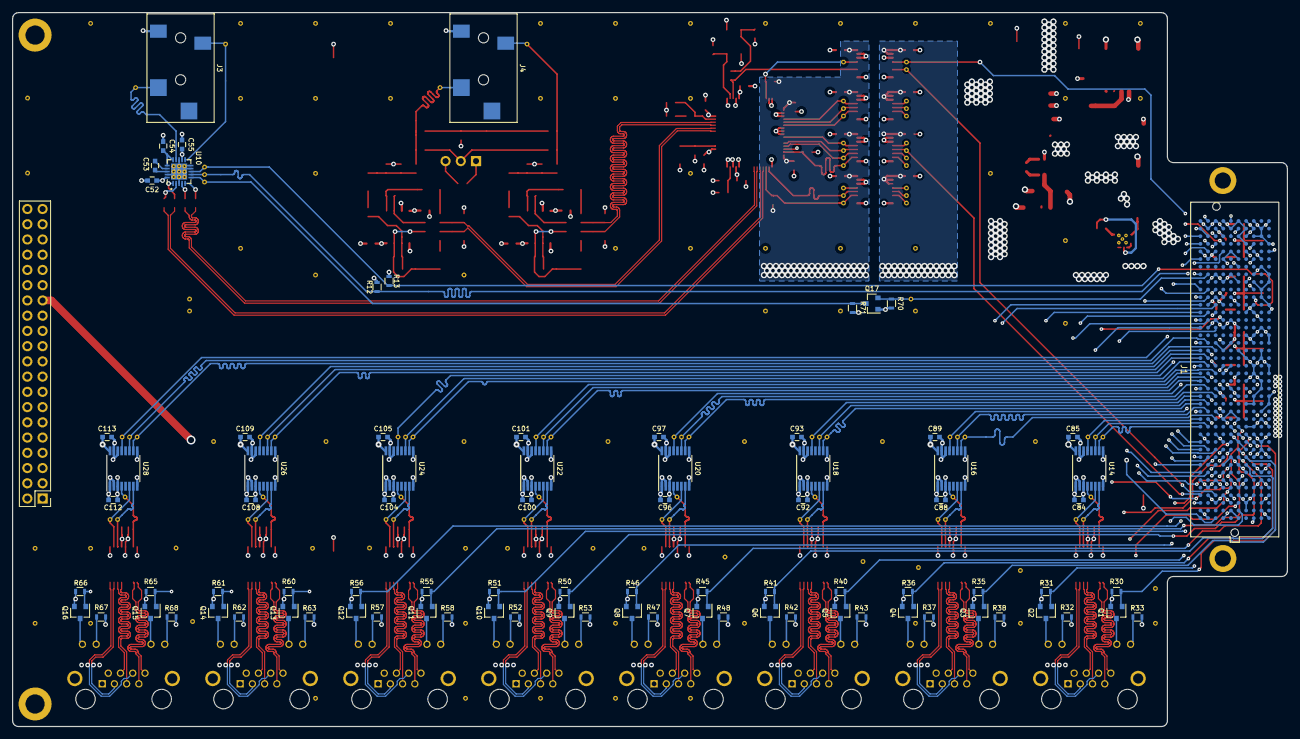
[picture p23: board audio_beamforming_daughter_board.kicad_pcb from below]

Board: 6 copper layers, 212.5 x 119.0 mm, 412 parts (86 on the bottom side), 266 nets.

Parts:
C1, C5, C7, C10, C22, C44: 10uF; C_0603
C2, C6, C8, C11: 100uF; C_1210
C3, C20: 10nF; C_0603
C4: 3300pF; C_0603
C9, C17: 22uF; C_0805
C12, C18, C82, C86, C90, C94, C98, C102, C106, C110: 0.1uF; C_0402
C13, C21: 47uF; CP_Elec_6.3x5.8
C14: 10uF; CP_Tantalum_Case-A_EIA-3216-18_Reflow
C15: 10nF; C_0402
C16, C23, C24, C25, C26, C27, C28, C29, C30, C31, C34, C35, C37, C39, C41, C42, C43, C45, C59, C68, C69, C70, C71, C84, C85, C88, C89, C92, C93, C96, C97, C100, C101, C104, C105, C108, C109, C112, C113: 0.1uF; C_0603
C19: 22uF; C_1206
C32, C33: 22pF; C_0603
C36: 390pF; C_0603
C38: 5600pF; C_0603
C40, C64, C65, C72, C73, C74, C75: 47uF; C_1210
C46, C47, C48, C49: 0.47uF; C_0603
C52, C53, C54, C55, C60, C61: 1.0uF; C_0603
C56, C57, C58, C76, C78, C79, C81: 1000pF; C_0603
C62, C63, C77, C80: 100pF; C_0603
C66, C67: 120pF; C_0603
C83, C87, C91, C95, C99, C103, C107, C111: 4700pF; C_0402
D1, D2, D3, D4: SML-LX0603SRW-TR; LED_0603
J1: ASP-134488-01; asp-134488-01
J2: TSW-120-07-F-D; Pin_Header_Straight_2x20_Pitch2.54mm
J3, J4: SJ-3523-SMT-TR; sj-352x-smt
J5: TSW-103-07-G-S; Pin_Header_Straight_1x03_Pitch2.54mm
J6, J7, J8, J9, J10, J11, J12, J13: 615008137421; WURTH_615008137421
L1: 2.2uH; xfl4020
L2: BLM18BA220SN1D; L_0603
Q1, Q2, Q3, Q4, Q5, Q6, Q7, Q8, Q9, Q10, Q11, Q12, Q13, Q14, Q15, Q16, Q17: NX138AKR; SOT-23
R1: 6.2; R_0603
R2: 107; R_0603
R3: 220; R_0603
R4: 100k; R_0603
R5: 680; R_0603
R6: 3.9; R_0603
R7: 49.9; R_0603
R8, R10, R11, R12, R13, R30, R31, R35, R36, R40, R41, R45, R46, R50, R51, R55, R56, R60, R61, R65, R66, R70, R71: 10k; R_0603
R9: 562; R_0603
R14, R15: 6.81k; R_0603
R16, R17: 4.99k; R_0603
R18, R19, R20, R21, R22, R23, R24, R25: 5.76k; R_0603
R26, R27, R28, R29: 237; R_0603
R32, R33, R37, R38, R42, R43, R47, R48, R52, R53, R57, R58, R62, R63, R67, R68: 330; R_0603
R34, R39, R44, R49, R54, R59, R64, R69: 100; R_0603
TP1, TP3: GNDA; Measurement_Point_SMD_1206
TP2, TP4: GNDD; Measurement_Point_SMD_1206
TP5: +1V8D; Measurement_Point_SMD_1206
TP6: -5VA; Measurement_Point_SMD_1206
TP7: +5VA; Measurement_Point_SMD_1206
TP8: +5VD; Measurement_Point_SMD_1206
TP9: +3V3A; Measurement_Point_SMD_1206
TP10: +3V3D; Measurement_Point_SMD_1206
TP11: +12VD; Measurement_Point_SMD_1206
TP12: MCLK0; Measurement_Point_Round-TH_0.4mm
TP13: HEADPHONE_OUT_DSDATA; Measurement_Point_Round-TH_0.4mm
TP14: HEADPHONE_OUT_DSDATA_3V3; Measurement_Point_Round-TH_0.4mm
TP15: DBCLK; Measurement_Point_Round-TH_0.4mm
TP16: DBCLK_3V3; Measurement_Point_Round-TH_0.4mm
TP17: DLRCLK; Measurement_Point_Round-TH_0.4mm
TP18: DLRCLK_3V3; Measurement_Point_Round-TH_0.4mm
TP19: LINE_IN_DSDATA; Measurement_Point_Round-TH_0.4mm
TP20: LINE_IN_DSDATA_3V3; Measurement_Point_Round-TH_0.4mm
TP21: ABCLK; Measurement_Point_Round-TH_0.4mm
TP22: ABCLK_3V3; Measurement_Point_Round-TH_0.4mm
TP23: ALRCLK; Measurement_Point_Round-TH_0.4mm
TP24: ALRCLK_3V3; Measurement_Point_Round-TH_0.4mm
TP25: ~RST_CODEC; Measurement_Point_Round-TH_0.4mm
TP26: ~RST_CODEC_3V3; Measurement_Point_Round-TH_0.4mm
TP27: SPI_IN; Measurement_Point_Round-TH_0.4mm
TP28: SPI_IN_3V3; Measurement_Point_Round-TH_0.4mm
TP29: SPI_OUT; Measurement_Point_Round-TH_0.4mm
TP30: SPI_OUT_3V3; Measurement_Point_Round-TH_0.4mm
TP31: SPI_CLK; Measurement_Point_Round-TH_0.4mm
TP32: SPI_CLK_3V3; Measurement_Point_Round-TH_0.4mm
TP33: ~SPI_LATCH; Measurement_Point_Round-TH_0.4mm
TP34: ~SPI_LATCH_3V3; Measurement_Point_Round-TH_0.4mm
TP35: ~HEADPHONE_SD; Measurement_Point_Round-TH_0.4mm
TP36: ~HEADPHONE_SD_3V3; Measurement_Point_Round-TH_0.4mm
TP37: HEADPHONE_SDA; Measurement_Point_Round-TH_0.4mm
TP38: HEADPHONE_SCL; Measurement_Point_Round-TH_0.4mm
TP39: HEADPHONE_OUT_R; Measurement_Point_Round-TH_0.4mm
TP40: HEADPHONE_OUT_L; Measurement_Point_Round-TH_0.4mm
TP41: LINE_IN_R; Measurement_Point_Round-TH_0.4mm
TP42: LINE_IN_L; Measurement_Point_Round-TH_0.4mm
TP43, TP49, TP55, TP61, TP67, TP73, TP79, TP85: SD_3V3; Measurement_Point_Round-TH_0.4mm
TP44, TP50, TP56, TP62, TP68, TP74, TP80, TP86: WS_3V3; Measurement_Point_Round-TH_0.4mm
TP45, TP51, TP57, TP63, TP69, TP75, TP81, TP87: SCK_3V3; Measurement_Point_Round-TH_0.4mm
TP46, TP52, TP58, TP64, TP70, TP76, TP82, TP88: SD; Measurement_Point_Round-TH_0.4mm
TP47, TP53, TP59, TP65, TP71, TP77, TP83, TP89: WS; Measurement_Point_Round-TH_0.4mm
TP48, TP54, TP60, TP66, TP72, TP78, TP84, TP90: SCK; Measurement_Point_Round-TH_0.4mm
U1: TPS62153RGTT; ti_vqfn-16
U2: ADP3303ARZ-3.3-RL7; SOIC-8_3.9x4.9mm_Pitch1.27mm
U3: LTC1983ES6-5#TRMPBF; TSOT-23-6
U4, U5, U6, U7, U14, U16, U18, U20, U22, U24, U26, U28: 74AVC4T245; TSSOP-16_4.4x5mm_Pitch0.65mm
U8: AD1939YSTZ; LQFP-64_10x10mm_Pitch0.5mm
U10: TPA6130A2; ti_pwqfn_n20
U11, U12: ADA4075-2; SOIC-8_3.9x4.9mm_Pitch1.27mm
U13, U15, U17, U19, U21, U23, U25, U27: SN65LVDS049; TSSOP-16_4.4x5mm_Pitch0.65mm
V3_1, V3_2, V4_1, V4_2, V4_4, V4_5, V4_5#2, V4_5#3, V4_5#4, V4_5#5, V4_5#6, V4_5#7, V4_5#8, V4_5#9, V4_5#10, V4_5#11, V4_5#12, V4_5#13, V4_5#14, V4_5#15, V5_1, V5_3, V6_1, V6_4, V6_9, V6_9#2, V6_9#3, V6_9#4, V7_1, V7_4, V8_1, V8_4, V9_1, V9_2, V9_3, V9_4, V9_10, V10_1, V10_2, V10_4, V10_9, V10_9#2, V10_10, V11_1, V11_2, V11_10, V12_8, V12_8#2, V12_8#3, V12_8#4, V12_8#5, V12_8#6, V12_8#7, V12_8#8, V12_9, V12_10, V13_1, V13_2, V14_1, V14_2, V14_3, V14_8, V14_10, V15_1, V15_2, V15_4, V16_8, V16_8#2, V16_8#3, V17_1, V17_8, V17_8#2, V17_9, V17_9#2, V18_2, V18_3: AUTO_VIA; VIA_MATRIX
Y1: ABM3B-12.288MHZ-10-1-U-T; Crystal_SMD_Abracon_ABM3B-4pin_5.0x3.2mm

Connections:
+1V8D: C1.1, C2.1, C28.2, C29.2, C30.2, C31.2, C85.2, C89.2, C93.2, C97.2, C101.2, C105.2, C109.2, C113.2, J1.E39, J1.F40, J1.G39, J1.H01, J1.H40, J1.J39, J1.K01, J1.K40, J2.27, Q17.1, R1.2, R70.1, TP5.1, U4.1, U4.2, U4.3, U5.1, U5.2, U6.1, U7.1, U7.2, U7.3, U14.16, U16.16, U18.16, U20.16, U22.16, U24.16, U26.16, U28.16
+3V3A: C12.1, C13.1, C15.2, C34.2, C35.2, C36.2, C41.2, C45.1, R9.1, TP9.1, U2.1, U2.2, U8.5, U8.45, U8.51, U8.62
+3V3D: C5.1, C6.1, C24.2, C25.2, C26.2, C27.2, C37.1, C42.1, C82.2, C83.2, C84.2, C86.2, C87.2, C88.2, C90.2, C91.2, C92.2, C94.2, C95.2, C96.2, C98.2, C99.2, C100.2, C102.2, C103.2, C104.2, C106.2, C107.2, C108.2, C110.2, C111.2, C112.2, J1.C39, J1.D32, J1.D36, J1.D38, J1.D40, J2.31, J6.1, J7.1, J8.1, J9.1, J10.1, J11.1, J12.1, J13.1, R2.2, R8.2, R11.2, R12.1, R13.2, R32.1, R33.1, R37.1, R38.1, R42.1, R43.1, R47.1, R48.1, R52.1, R53.1, R57.1, R58.1, R62.1, R63.1, R67.1, R68.1, R71.1, TP10.1, U4.16, U5.16, U6.16, U7.16, U8.17, U8.32, U13.12, U13.16, U14.1, U14.2, U15.12, U15.16, U16.1, U16.2, U17.12, U17.16, U18.1, U18.2, U19.12, U19.16, U20.1, U20.2, U21.12, U21.16, U22.1, U22.2, U23.12, U23.16, U24.1, U24.2, U25.12, U25.16, U26.1, U26.2, U27.12, U27.16, U28.1, U28.2
+5VA: C17.1, C20.1, C23.1, C52.2, C55.2, C59.2, C68.2, C70.1, J5.3, L2.2, TP7.1, U10.12, U10.20, U11.8, U12.8
+5VD: C7.1, C8.1, C9.1, C14.1, C18.1, C21.1, J2.35, L1.2, L2.1, R3.2, R4.1, TP8.1, U1.14, U2.5, U2.7, U2.8, U3.1, U3.6
+12VD: C3.1, C10.1, C11.1, J1.C35, J1.C37, J2.39, R5.2, TP11.1, U1.10, U1.11, U1.12, U1.13
-5VA: C22.1, C69.1, C71.1, R6.1, TP6.1, U11.4, U12.4
/FMC Connector/ABCLK: J1.K04, TP21.1, U6.5
/FMC Connector/ALRCLK: J1.J37, TP23.1, U6.6
/FMC Connector/DBCLK: J1.H38, TP15.1, U7.5
/FMC Connector/DLRCLK: J1.K38, TP17.1, U7.6
/FMC Connector/GPIO0: J1.G10, J2.1
/FMC Connector/GPIO1: J1.F10, J2.2
/FMC Connector/GPIO2: J1.F11, J2.3
/FMC Connector/GPIO3: J1.G06, J2.4
/FMC Connector/GPIO4: J1.F07, J2.5
/FMC Connector/GPIO5: J1.G07, J2.6
/FMC Connector/GPIO6: J1.F08, J2.7
/FMC Connector/GPIO7: J1.J07, J2.8
/FMC Connector/GPIO8: J1.K07, J2.9
/FMC Connector/GPIO9: J1.H07, J2.10
/FMC Connector/GPIO10: J1.K08, J2.11
/FMC Connector/GPIO11: J1.H08, J2.12
/FMC Connector/GPIO12: J1.G09, J2.13
/FMC Connector/GPIO13: J1.J09, J2.14
/FMC Connector/GPIO14: J1.H10, J2.15
/FMC Connector/GPIO15: J1.K10, J2.16
/FMC Connector/GPIO16: J1.J10, J2.17
/FMC Connector/GPIO17: J1.K11, J2.18
/FMC Connector/GPIO18: J1.H26, J2.19
/FMC Connector/GPIO19: J1.K26, J2.20
/FMC Connector/GPIO20: J1.G27, J2.21
/FMC Connector/GPIO21: J1.J27, J2.22
/FMC Connector/GPIO22: J1.H28, J2.23
/FMC Connector/GPIO23: J1.J28, J2.24
/FMC Connector/GPIO24: J1.K28, J2.25
/FMC Connector/GPIO25: J1.H29, J2.26
/FMC Connector/GPIO26: J1.K29, J2.29
/FMC Connector/GPIO27: J1.G30, J2.30
/FMC Connector/GPIO28: J1.J30, J2.33
/FMC Connector/GPIO29: J1.H31, J2.34
/FMC Connector/GPIO30: J1.J31, J2.37
/FMC Connector/GPIO31: J1.K31, J2.38
/FMC Connector/HEADPHONE_OUT_DSDATA: J1.G37, TP13.1, U7.4
/FMC Connector/HEADPHONE_SCL: J1.C30, R13.1, TP38.1, U10.8
/FMC Connector/HEADPHONE_SDA: J1.C31, R12.2, TP37.1, U10.7
/FMC Connector/LINE_IN_DSDATA: J1.K37, TP19.1, U6.4
/FMC Connector/MCLK0: J1.H04, TP12.1, U5.6
/FMC Connector/SPI_CLK: J1.G36, TP31.1, U4.5
/FMC Connector/SPI_IN: J1.H37, TP27.1, U4.4
/FMC Connector/SPI_OUT: J1.J36, TP29.1, U6.7
/FMC Connector/~HEADPHONE_SD: J1.J33, Q17.2, R70.2, TP35.1
/FMC Connector/~RST_CODEC: J1.E34, TP25.1, U5.4
/FMC Connector/~SPI_LATCH: J1.K35, TP33.1, U4.6
/LED_SD_CH0: J1.C10, Q2.1, R31.1
/LED_SD_CH1: J1.E10, Q4.1, R36.1
/LED_SD_CH2: J1.D08, Q6.1, R41.1
/LED_SD_CH3: J1.E06, Q8.1, R46.1
/LED_SD_CH4: J1.E12, Q10.1, R51.1
/LED_SD_CH5: J1.F13, Q12.1, R56.1
/LED_SD_CH6: J1.E03, Q14.1, R61.1
/LED_SD_CH7: J1.F05, Q16.1, R66.1
/LED_WS_CH0: J1.C11, Q1.1, R30.1
/LED_WS_CH1: J1.D09, Q3.1, R35.1
/LED_WS_CH2: J1.D11, Q5.1, R40.1
/LED_WS_CH3: J1.E09, Q7.1, R45.1
/LED_WS_CH4: J1.D12, Q9.1, R50.1
/LED_WS_CH5: J1.E13, Q11.1, R55.1
/LED_WS_CH6: J1.E02, Q13.1, R60.1
/LED_WS_CH7: J1.F04, Q15.1, R65.1
/Microphone Array Interface Ch0/SCK+: J6.3, U13.7
/Microphone Array Interface Ch0/SCK-: J6.6, U13.8
/Microphone Array Interface Ch0/SCK_3V3: TP45.1, U13.10, U14.6
/Microphone Array Interface Ch0/SD+: J6.7, R34.1, U13.2
/Microphone Array Interface Ch0/SD-: J6.8, R34.2, U13.1
/Microphone Array Interface Ch0/SD_3V3: TP43.1, U13.15, U14.4
/Microphone Array Interface Ch0/WS+: J6.4, U13.6
/Microphone Array Interface Ch0/WS-: J6.5, U13.5
/Microphone Array Interface Ch0/WS_3V3: TP44.1, U13.11, U14.7
/Microphone Array Interface Ch1/SCK+: J7.3, U15.7
/Microphone Array Interface Ch1/SCK-: J7.6, U15.8
/Microphone Array Interface Ch1/SCK_3V3: TP51.1, U15.10, U16.6
/Microphone Array Interface Ch1/SD+: J7.7, R39.1, U15.2
/Microphone Array Interface Ch1/SD-: J7.8, R39.2, U15.1
/Microphone Array Interface Ch1/SD_3V3: TP49.1, U15.15, U16.4
/Microphone Array Interface Ch1/WS+: J7.4, U15.6
/Microphone Array Interface Ch1/WS-: J7.5, U15.5
/Microphone Array Interface Ch1/WS_3V3: TP50.1, U15.11, U16.7
/Microphone Array Interface Ch2/SCK+: J8.3, U17.7
/Microphone Array Interface Ch2/SCK-: J8.6, U17.8
/Microphone Array Interface Ch2/SCK_3V3: TP57.1, U17.10, U18.6
/Microphone Array Interface Ch2/SD+: J8.7, R44.1, U17.2
/Microphone Array Interface Ch2/SD-: J8.8, R44.2, U17.1
/Microphone Array Interface Ch2/SD_3V3: TP55.1, U17.15, U18.4
/Microphone Array Interface Ch2/WS+: J8.4, U17.6
/Microphone Array Interface Ch2/WS-: J8.5, U17.5
/Microphone Array Interface Ch2/WS_3V3: TP56.1, U17.11, U18.7
/Microphone Array Interface Ch3/SCK+: J9.3, U19.7
/Microphone Array Interface Ch3/SCK-: J9.6, U19.8
/Microphone Array Interface Ch3/SCK_3V3: TP63.1, U19.10, U20.6
/Microphone Array Interface Ch3/SD+: J9.7, R49.1, U19.2
/Microphone Array Interface Ch3/SD-: J9.8, R49.2, U19.1
/Microphone Array Interface Ch3/SD_3V3: TP61.1, U19.15, U20.4
/Microphone Array Interface Ch3/WS+: J9.4, U19.6
/Microphone Array Interface Ch3/WS-: J9.5, U19.5
/Microphone Array Interface Ch3/WS_3V3: TP62.1, U19.11, U20.7
/Microphone Array Interface Ch4/SCK+: J10.3, U21.7
/Microphone Array Interface Ch4/SCK-: J10.6, U21.8
/Microphone Array Interface Ch4/SCK_3V3: TP69.1, U21.10, U22.6
/Microphone Array Interface Ch4/SD+: J10.7, R54.1, U21.2
/Microphone Array Interface Ch4/SD-: J10.8, R54.2, U21.1
/Microphone Array Interface Ch4/SD_3V3: TP67.1, U21.15, U22.4
/Microphone Array Interface Ch4/WS+: J10.4, U21.6
/Microphone Array Interface Ch4/WS-: J10.5, U21.5
/Microphone Array Interface Ch4/WS_3V3: TP68.1, U21.11, U22.7
/Microphone Array Interface Ch5/SCK+: J11.3, U23.7
/Microphone Array Interface Ch5/SCK-: J11.6, U23.8
/Microphone Array Interface Ch5/SCK_3V3: TP75.1, U23.10, U24.6
/Microphone Array Interface Ch5/SD+: J11.7, R59.1, U23.2
/Microphone Array Interface Ch5/SD-: J11.8, R59.2, U23.1
/Microphone Array Interface Ch5/SD_3V3: TP73.1, U23.15, U24.4
/Microphone Array Interface Ch5/WS+: J11.4, U23.6
/Microphone Array Interface Ch5/WS-: J11.5, U23.5
/Microphone Array Interface Ch5/WS_3V3: TP74.1, U23.11, U24.7
/Microphone Array Interface Ch6/SCK+: J12.3, U25.7
/Microphone Array Interface Ch6/SCK-: J12.6, U25.8
/Microphone Array Interface Ch6/SCK_3V3: TP81.1, U25.10, U26.6
/Microphone Array Interface Ch6/SD+: J12.7, R64.1, U25.2
/Microphone Array Interface Ch6/SD-: J12.8, R64.2, U25.1
/Microphone Array Interface Ch6/SD_3V3: TP79.1, U25.15, U26.4
/Microphone Array Interface Ch6/WS+: J12.4, U25.6
/Microphone Array Interface Ch6/WS-: J12.5, U25.5
/Microphone Array Interface Ch6/WS_3V3: TP80.1, U25.11, U26.7
/Microphone Array Interface Ch7/SCK+: J13.3, U27.7
/Microphone Array Interface Ch7/SCK-: J13.6, U27.8
/Microphone Array Interface Ch7/SCK_3V3: TP87.1, U27.10, U28.6
/Microphone Array Interface Ch7/SD+: J13.7, R69.1, U27.2
/Microphone Array Interface Ch7/SD-: J13.8, R69.2, U27.1
/Microphone Array Interface Ch7/SD_3V3: TP85.1, U27.15, U28.4
/Microphone Array Interface Ch7/WS+: J13.4, U27.6
/Microphone Array Interface Ch7/WS-: J13.5, U27.5
/Microphone Array Interface Ch7/WS_3V3: TP86.1, U27.11, U28.7
/SCK_CH0: J1.J13, TP48.1, U14.11
/SCK_CH1: J1.J15, TP54.1, U16.11
/SCK_CH2: J1.J16, TP60.1, U18.11
/SCK_CH3: J1.J18, TP66.1, U20.11
/SCK_CH4: J1.J19, TP72.1, U22.11
/SCK_CH5: J1.J21, TP78.1, U24.11
/SCK_CH6: J1.J22, TP84.1, U26.11
/SCK_CH7: J1.J24, TP90.1, U28.11
/SD_CH0: J1.K14, TP46.1, U14.13
/SD_CH1: J1.G15, TP52.1, U16.13
/SD_CH2: J1.K17, TP58.1, U18.13
/SD_CH3: J1.G18, TP64.1, U20.13
/SD_CH4: J1.K20, TP70.1, U22.13
/SD_CH5: J1.G21, TP76.1, U24.13
/SD_CH6: J1.K23, TP82.1, U26.13
/SD_CH7: J1.G24, TP88.1, U28.13
/WS_CH0: J1.K13, TP47.1, U14.10
/WS_CH1: J1.H14, TP53.1, U16.10
/WS_CH2: J1.K16, TP59.1, U18.10
/WS_CH3: J1.H17, TP65.1, U20.10
/WS_CH4: J1.K19, TP71.1, U22.10
/WS_CH5: J1.H20, TP77.1, U24.10
/WS_CH6: J1.K22, TP83.1, U26.10
/WS_CH7: J1.H23, TP89.1, U28.10
/audio_codec/ABCLK_3V3: TP22.1, U6.12, U8.28
/audio_codec/ALRCLK_3V3: TP24.1, U6.11, U8.29
/audio_codec/DBCLK_3V3: TP16.1, U7.12, U8.21
/audio_codec/DLRCLK_3V3: TP18.1, U7.11, U8.22
/audio_codec/HEADPHONE_OUT_DSDATA_3V3: TP14.1, U7.13, U8.20
/audio_codec/HEADPHONE_OUT_L_N: C46.2, U8.37
/audio_codec/HEADPHONE_OUT_L_P: C47.2, U8.36
/audio_codec/HEADPHONE_OUT_R_N: C49.2, U8.39
/audio_codec/HEADPHONE_OUT_R_P: C48.2, U8.38
/audio_codec/LINE_IN_DSDATA_3V3: TP20.1, U6.13, U8.26
/audio_codec/LINE_IN_L_N: C79.1, C80.2, R28.2, U8.58
/audio_codec/LINE_IN_L_P: C80.1, C81.2, R29.2, U8.57
/audio_codec/LINE_IN_R_N: C76.1, C77.2, R26.2, U8.60
/audio_codec/LINE_IN_R_P: C77.1, C78.2, R27.2, U8.59
/audio_codec/MCLK0_3V3: R7.1, U5.11, U8.3
/audio_codec/MCLKI: C32.1, U8.2, Y1.1
/audio_codec/SPI_CLK_3V3: TP32.1, U4.12, U8.34
/audio_codec/SPI_IN_3V3: TP28.1, U4.13, U8.30
/audio_codec/SPI_OUT_3V3: R10.1, TP30.1, U6.10, U8.31
/audio_codec/~RST_CODEC_3V3: R8.1, TP26.1, U5.13, U8.14
/audio_codec/~SPI_LATCH_3V3: R11.1, TP34.1, U4.11, U8.35
/headphone_out/HEADPHONE_OUT_L: J3.1, TP40.1, U10.14
/headphone_out/HEADPHONE_OUT_R: J3.2, TP39.1, U10.11
/headphone_out/~HEADPHONE_SD_3V3: Q17.3, R71.2, TP36.1, U10.6
/line_in/LINE_IN_L: C58.2, C61.2, J4.1, R15.2, TP42.1
/line_in/LINE_IN_R: C57.1, C60.2, J4.2, R14.1, TP41.1
GND: C1.2, C2.2, C3.2, C4.2, C5.2, C6.2, C7.2, C8.2, C9.2, C10.2, C11.2, C12.2, C13.2, C14.2, C17.2, C18.2, C19.2, C20.2, C21.2, C22.2, C23.2, C24.1, C25.1, C26.1, C27.1, C28.1, C29.1, C30.1, C31.1, C32.2, C33.2, C34.1, C35.1, C37.2, C39.1, C40.1, C41.1, C42.2, C43.1, C44.1, C45.2, C52.1, C54.1, C55.1, C56.2, C59.1, C62.1, C63.1, C68.1, C69.2, C70.2, C71.2, C76.2, C78.1, C79.2, C81.1, C82.1, C83.1, C84.1, C85.1, C86.1, C87.1, C88.1, C89.1, C90.1, C91.1, C92.1, C93.1, C94.1, C95.1, C96.1, C97.1, C98.1, C99.1, C100.1, C101.1, C102.1, C103.1, C104.1, C105.1, C106.1, C107.1, C108.1, C109.1, C110.1, C111.1, C112.1, C113.1, D1.1, D2.1, D3.1, D4.1, J1.A01, J1.A04, J1.A05, J1.A08, J1.A09, J1.A12, J1.A13, J1.A16, J1.A17, J1.A20, J1.A21, J1.A24, J1.A25, J1.A28, J1.A29, J1.A32, J1.A33, J1.A36, J1.A37, J1.A40, J1.B02, J1.B03, J1.B06, J1.B07, J1.B10, J1.B11, J1.B14, J1.B15, J1.B18, J1.B19, J1.B22, J1.B23, J1.B26, J1.B27, J1.B30, J1.B31, J1.B34, J1.B35, J1.B38, J1.B39, J1.C01, J1.C04, J1.C05, J1.C08, J1.C09, J1.C12, J1.C13, J1.C16, J1.C17, J1.C20, J1.C21, J1.C24, J1.C25, J1.C28, J1.C29, J1.C32, J1.C33, J1.C36, J1.C38, J1.C40, J1.D02, J1.D03, J1.D06, J1.D07, J1.D10, J1.D13, J1.D16, J1.D19, J1.D22, J1.D25, J1.D28, J1.D37, J1.D39, J1.E01, J1.E04, J1.E05, J1.E08, J1.E11, J1.E14, J1.E17, J1.E20, J1.E23, J1.E26, J1.E29, J1.E32, J1.E35, J1.E38, J1.E40, J1.F02, J1.F03, J1.F06, J1.F09, J1.F12, J1.F15, J1.F18, J1.F21, J1.F24, J1.F27, J1.F30, J1.F33, J1.F36, J1.F39, J1.G01, J1.G04, J1.G05, J1.G08, J1.G11, J1.G14, J1.G17, J1.G20, J1.G23, J1.G26, J1.G29, J1.G32, J1.G35, J1.G38, J1.G40, J1.H03, J1.H06, J1.H09, J1.H12, J1.H15, J1.H18, J1.H21, J1.H24, J1.H27, J1.H30, J1.H33, J1.H36, J1.H39, J1.J01, J1.J04, J1.J05, J1.J08, J1.J11, J1.J14, J1.J17, J1.J20, J1.J23, J1.J26, J1.J29, J1.J32, J1.J35, J1.J38, J1.J40, J1.K02, J1.K03, J1.K06, J1.K09, J1.K12, J1.K15, J1.K18, J1.K21, J1.K24, J1.K27, J1.K30, J1.K33, J1.K36, J1.K39, J2.28, J2.32, J2.36, J2.40, J3.3, J4.3, J5.1, J6.2, J6.13, J6.14, J7.2, J7.13, J7.14, J8.2, J8.13, J8.14, J9.2, J9.13, J9.14, J10.2, J10.13, J10.14, J11.2, J11.13, J11.14, J12.2, J12.13, J12.14, J13.2, J13.13, J13.14, Q1.2, Q2.2, Q3.2, Q4.2, Q5.2, Q6.2, Q7.2, Q8.2, Q9.2, Q10.2, Q11.2, Q12.2, Q13.2, Q14.2, Q15.2, Q16.2, R10.2, R16.1, R17.1, R30.2, R31.2, R35.2, R36.2, R40.2, R41.2, R45.2, R46.2, R50.2, R51.2, R55.2, R56.2, R60.2, R61.2, R65.2, R66.2, TP1.1, TP2.1, TP3.1, TP4.1, U1.5, U1.6, U1.7, U1.8, U1.15, U1.16, U1.17, U2.4, U3.5, U4.8, U4.9, U4.14, U4.15, U5.3, U5.8, U5.9, U5.14, U5.15, U6.2, U6.3, U6.8, U6.9, U6.14, U6.15, U7.8, U7.9, U7.14, U7.15, U8.1, U8.4, U8.15, U8.16, U8.18, U8.19, U8.23, U8.24, U8.25, U8.33, U8.44, U8.46, U8.48, U10.3, U10.9, U10.10, U10.13, U10.19, U10.21, U11.3, U11.5, U12.3, U12.5, U13.9, U13.13, U14.3, U14.8, U14.9, U14.14, U14.15, U15.9, U15.13, U16.3, U16.8, U16.9, U16.14, U16.15, U17.9, U17.13, U18.3, U18.8, U18.9, U18.14, U18.15, U19.9, U19.13, U20.3, U20.8, U20.9, U20.14, U20.15, U21.9, U21.13, U22.3, U22.8, U22.9, U22.14, U22.15, U23.9, U23.13, U24.3, U24.8, U24.9, U24.14, U24.15, U25.9, U25.13, U26.3, U26.8, U26.9, U26.14, U26.15, U27.9, U27.13, U28.3, U28.8, U28.9, U28.14, U28.15, V3_1.1, V3_2.1, V4_1.1, V4_2.1, V4_4.1, V4_5.1, V4_5#2.1, V4_5#3.1, V4_5#4.1, V4_5#5.1, V4_5#6.1, V4_5#7.1, V4_5#8.1, V4_5#9.1, V4_5#10.1, V4_5#11.1, V4_5#12.1, V4_5#13.1, V4_5#14.1, V4_5#15.1, V5_1.1, V5_3.1, V6_1.1, V6_4.1, V6_9.1, V6_9#2.1, V6_9#3.1, V6_9#4.1, V7_1.1, V7_4.1, V8_1.1, V8_4.1, V9_1.1, V9_2.1, V9_3.1, V9_4.1, V9_10.1, V10_1.1, V10_2.1, V10_4.1, V10_9.1, V10_9#2.1, V10_10.1, V11_1.1, V11_2.1, V11_10.1, V12_8.1, V12_8#2.1, V12_8#3.1, V12_8#4.1, V12_8#5.1, V12_8#6.1, V12_8#7.1, V12_8#8.1, V12_9.1, V12_10.1, V13_1.1, V13_2.1, V14_1.1, V14_2.1, V14_3.1, V14_8.1, V14_10.1, V15_1.1, V15_2.1, V15_4.1, V16_8.1, V16_8#2.1, V16_8#3.1, V17_1.1, V17_8.1, V17_8#2.1, V17_9.1, V17_9#2.1, V18_2.1, V18_3.1, Y1.2, Y1.4
unnamed: C4.1, U1.9
unnamed: C15.1, U2.3
unnamed: C16.1, U3.4
unnamed: C16.2, U3.3
unnamed: C19.1, R6.2, U3.2
unnamed: C33.1, R7.2, Y1.3
unnamed: C36.1, C38.1, U8.61
unnamed: C38.2, R9.2
unnamed: C39.2, C40.2, U8.52
unnamed: C43.2, C44.2, U8.47
unnamed: C46.1, U10.1
unnamed: C47.1, U10.2
unnamed: C48.1, U10.4
unnamed: C49.1, U10.5
unnamed: C53.1, U10.17
unnamed: C53.2, U10.18
unnamed: C54.2, U10.15, U10.16
unnamed: C56.1, C57.2, C58.1
unnamed: C60.1, C62.2, C64.1, R16.2
unnamed: C61.1, C63.2, C65.1, R17.2
unnamed: C64.2, R18.1
unnamed: C65.2, R19.1
unnamed: C66.1, R19.2, R20.1, U12.6
unnamed: C66.2, C75.2, R20.2, R23.1, U12.7
unnamed: C67.1, R18.2, R21.1, U11.6
unnamed: C67.2, C73.2, R21.2, R22.1, U11.7
unnamed: C72.1, R26.1
unnamed: C72.2, R24.2, U11.1
unnamed: C73.1, R27.1
unnamed: C74.1, R28.1
unnamed: C74.2, R25.2, U12.1
unnamed: C75.1, R29.1
unnamed: D1.2, R1.1
unnamed: D2.2, R2.1
unnamed: D3.2, R3.1
unnamed: D4.2, R5.1
unnamed: J5.2, R14.2, R15.1
unnamed: J6.9, R33.2
unnamed: J6.10, Q1.3
unnamed: J6.11, R32.2
unnamed: J6.12, Q2.3
unnamed: J7.9, R38.2
unnamed: J7.10, Q3.3
unnamed: J7.11, R37.2
unnamed: J7.12, Q4.3
unnamed: J8.9, R43.2
unnamed: J8.10, Q5.3
unnamed: J8.11, R42.2
unnamed: J8.12, Q6.3
unnamed: J9.9, R48.2
unnamed: J9.10, Q7.3
unnamed: J9.11, R47.2
unnamed: J9.12, Q8.3
unnamed: J10.9, R53.2
unnamed: J10.10, Q9.3
unnamed: J10.11, R52.2
unnamed: J10.12, Q10.3
unnamed: J11.9, R58.2
unnamed: J11.10, Q11.3
unnamed: J11.11, R57.2
unnamed: J11.12, Q12.3
unnamed: J12.9, R63.2
unnamed: J12.10, Q13.3
unnamed: J12.11, R62.2
unnamed: J12.12, Q14.3
unnamed: J13.9, R68.2
unnamed: J13.10, Q15.3
unnamed: J13.11, R67.2
unnamed: J13.12, Q16.3
unnamed: L1.1, U1.1, U1.2, U1.3
unnamed: R4.2, U1.4
unnamed: R22.2, R24.1, U11.2
unnamed: R23.2, R25.1, U12.2
